wuxx/nanoDAP/README.md

## [nanoDAP 用户手册](https://github.com/wuxx/nanoDAP/blob/master/user_manual.md) / [nanoDAP User Manual](https://github.com/wuxx/nanoDAP/blob/master/user_manual_en.md)
## [nanoDAP DIY教程](https://github.com/wuxx/nanoDAP/blob/master/diy_tutorial.md) / [nanoDAP DIY Tutorials](https://github.com/wuxx/nanoDAP/blob/master/diy_tutorial.md)
