wuxx/nanoDAP/driver/windows7_serial_driver/README.md

CMSIS-DAP和DAPLink统一使用 mbedWinSerial_16466.exe 安装驱动，一般均可顺利安装。
