wuxx/nanoDAP/doc/a1.png

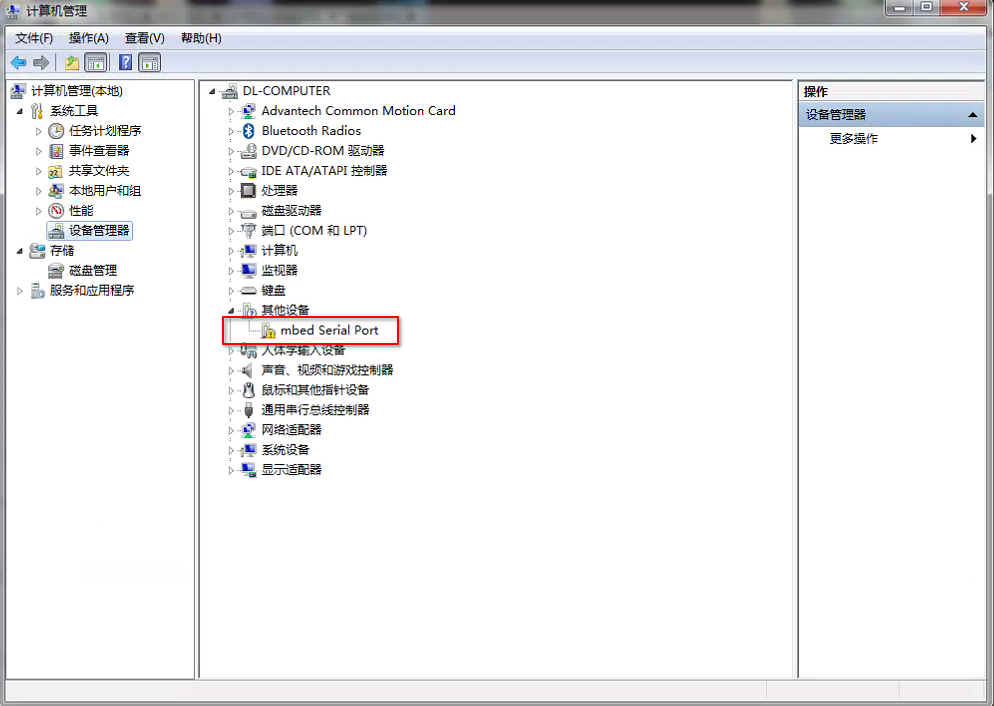
doc/a1.png
