wuxx/nanoDAP/doc/a2.png

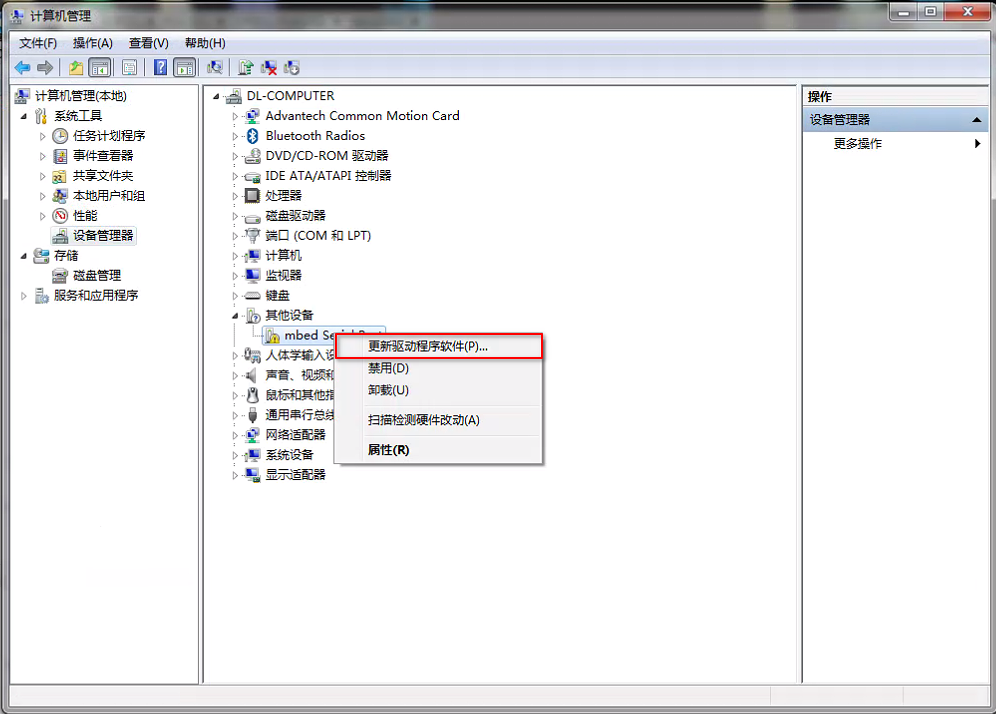
doc/a2.png
