wuxx/nanoDAP/doc/a3.png

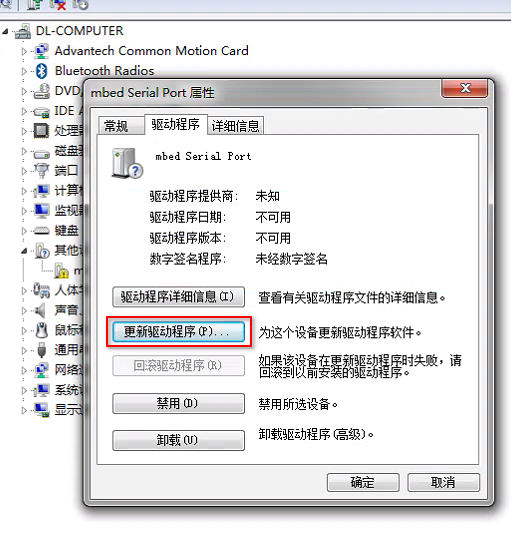
doc/a3.png
