wuxx/nanoDAP/doc/a4.png

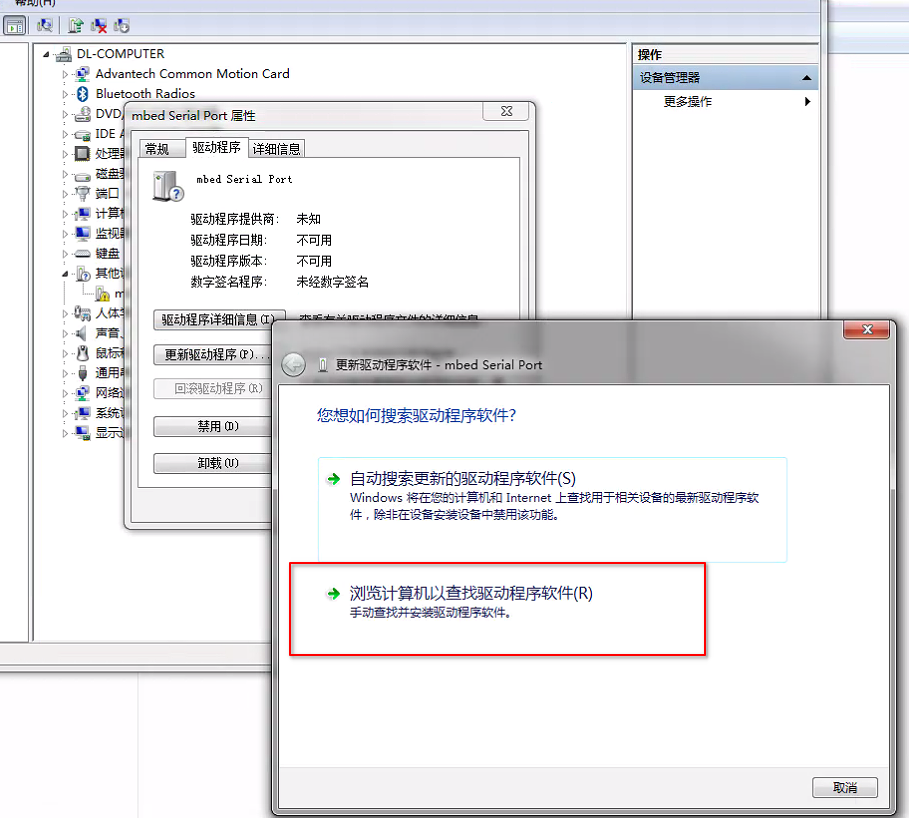
doc/a4.png
