wuxx/nanoDAP/doc/a5.png

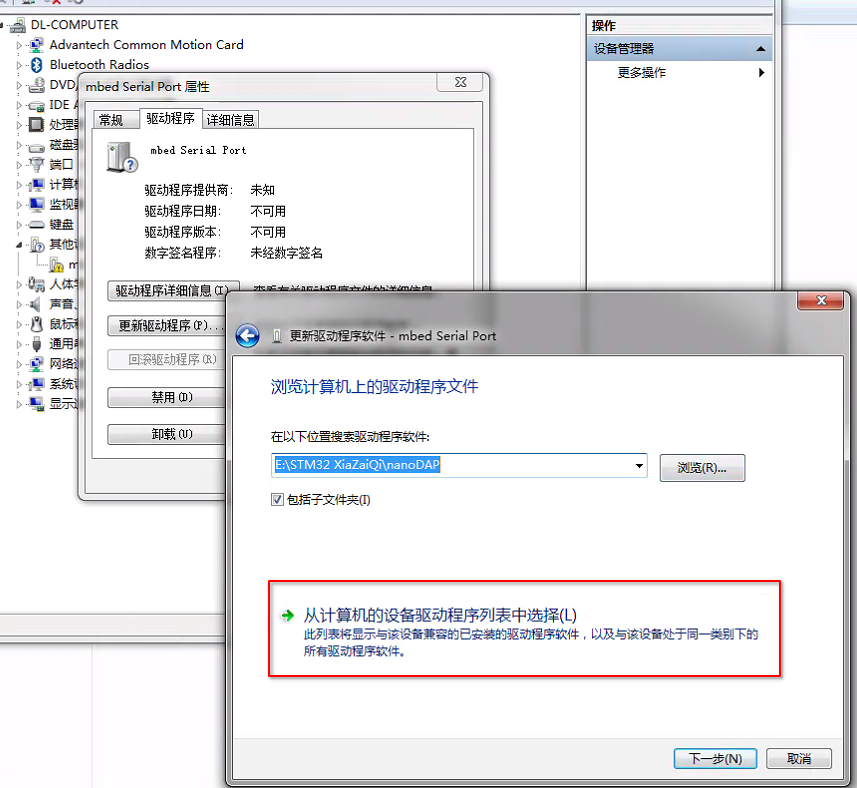
doc/a5.png
