wuxx/nanoDAP/doc/a6.png

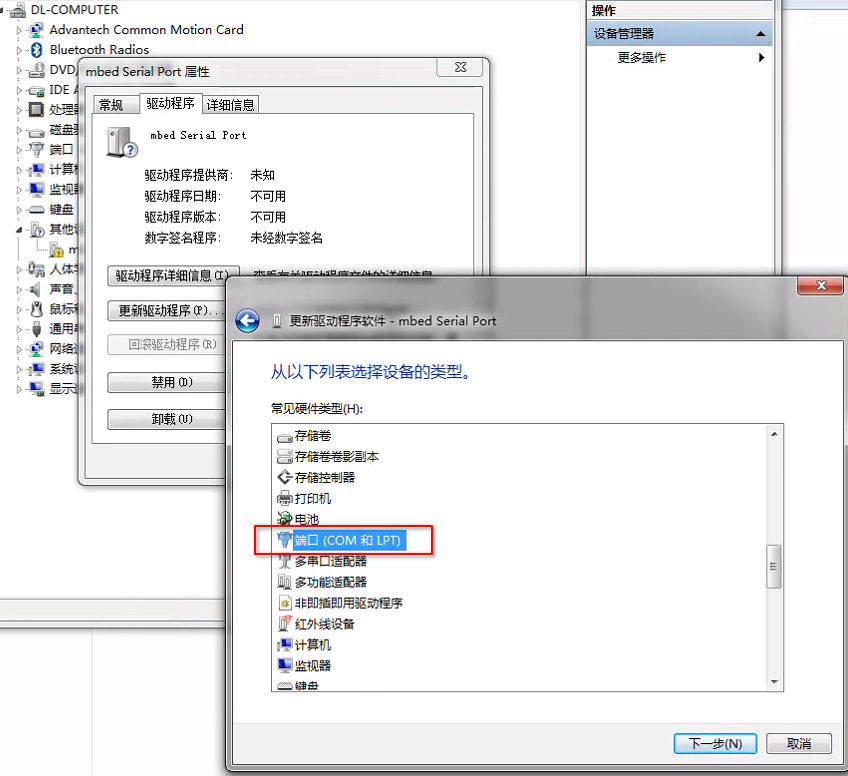
doc/a6.png
