wuxx/nanoDAP/doc/a7.png

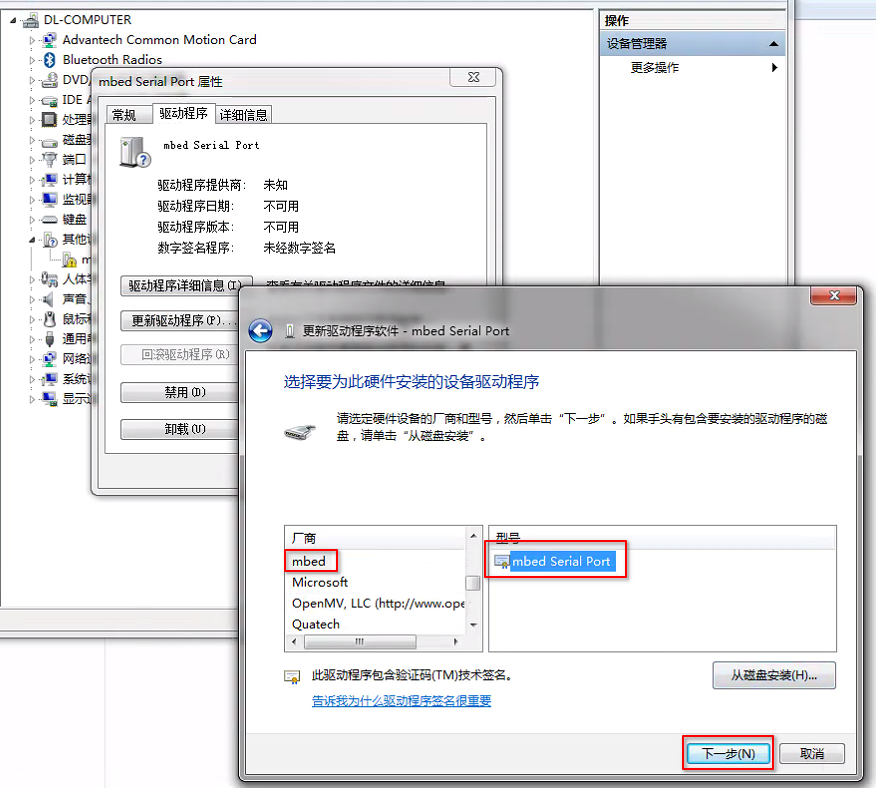
doc/a7.png
