wuxx/nanoDAP/doc/DAPLink_MSD1.png

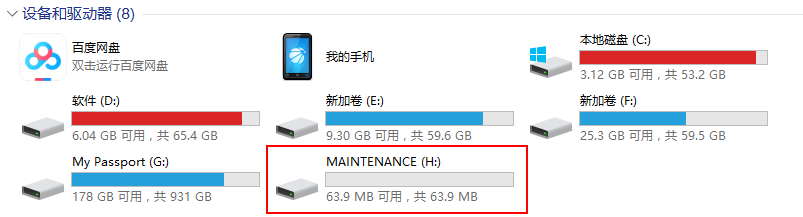
doc/DAPLink_MSD1.png
