wuxx/nanoDAP/doc/iar_config.png

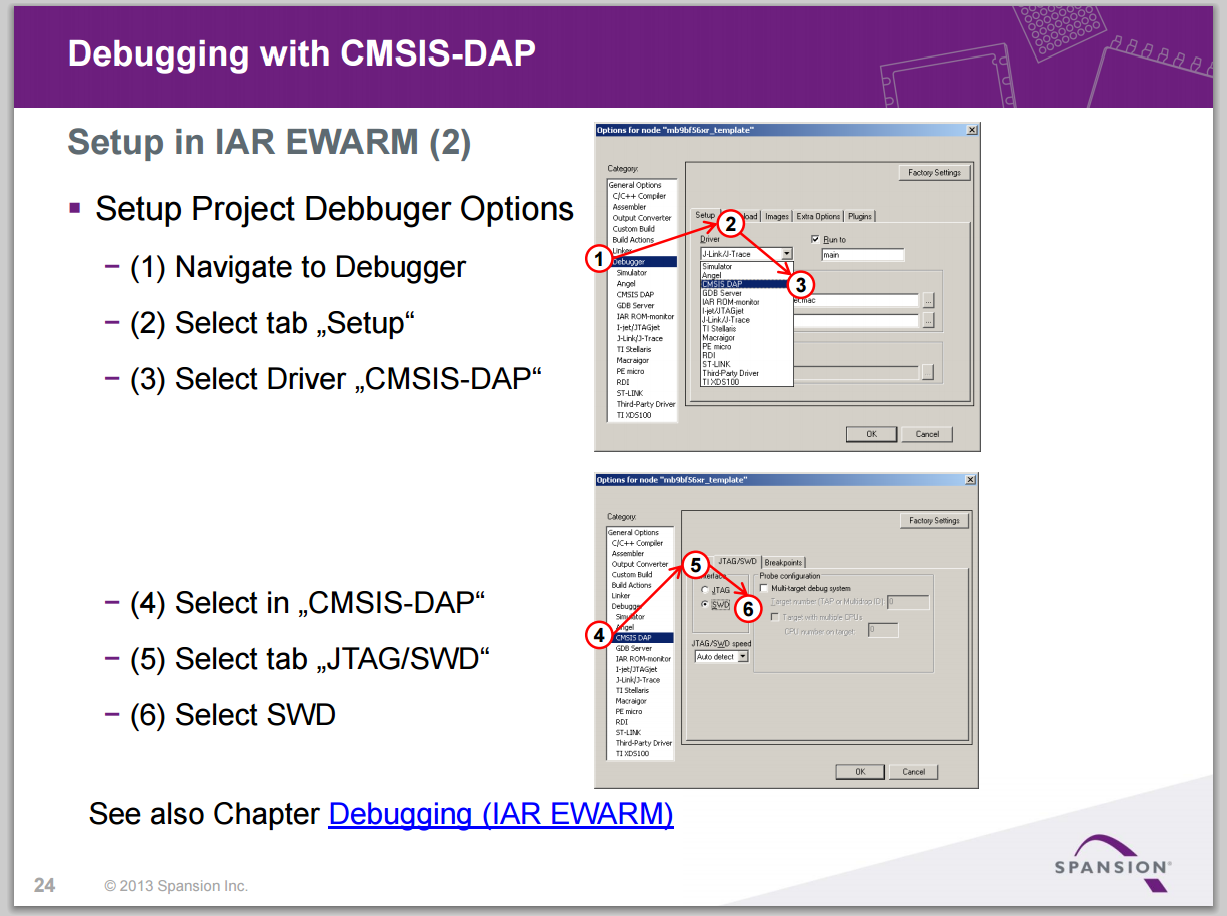
doc/iar_config.png
