wuxx/nanoDAP/doc/JTAG-SWD.png

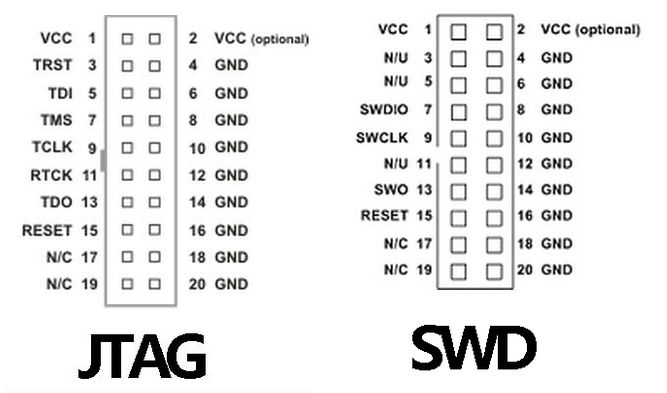
doc/JTAG-SWD.png
