wuxx/nanoDAP/doc/nanoDAP0.jpg

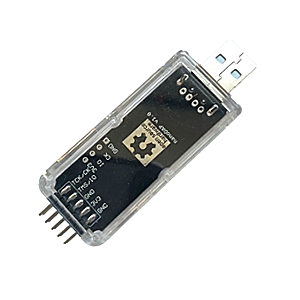
doc/nanoDAP0.jpg
