wuxx/nanoDAP/doc/nanoDAP3.jpg

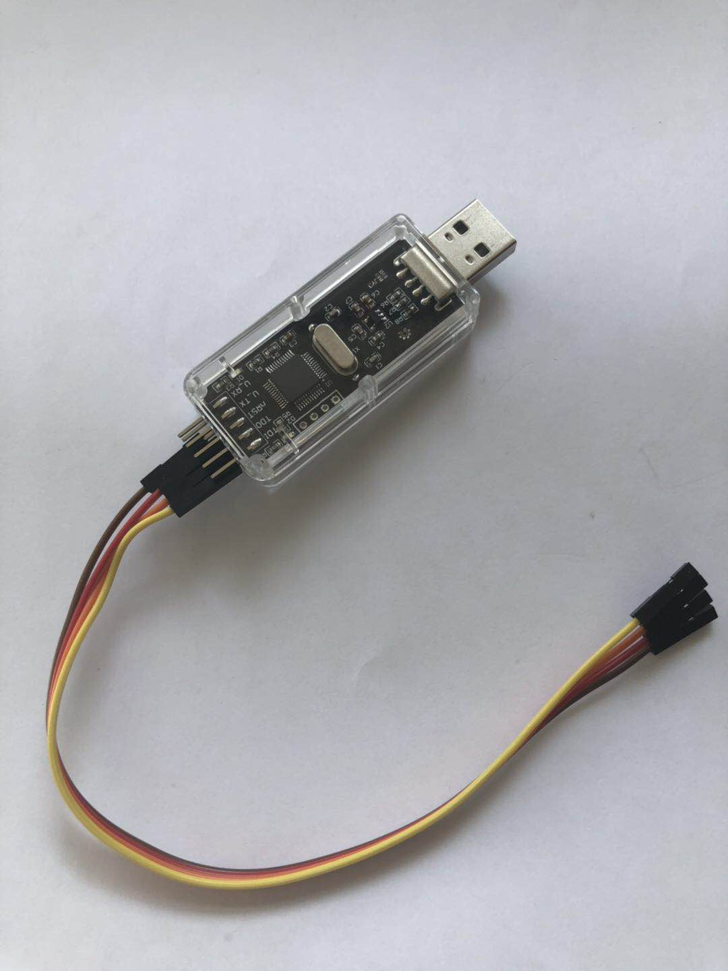
doc/nanoDAP3.jpg
