wuxx/nanoDAP/doc/nanoDAP4.jpg

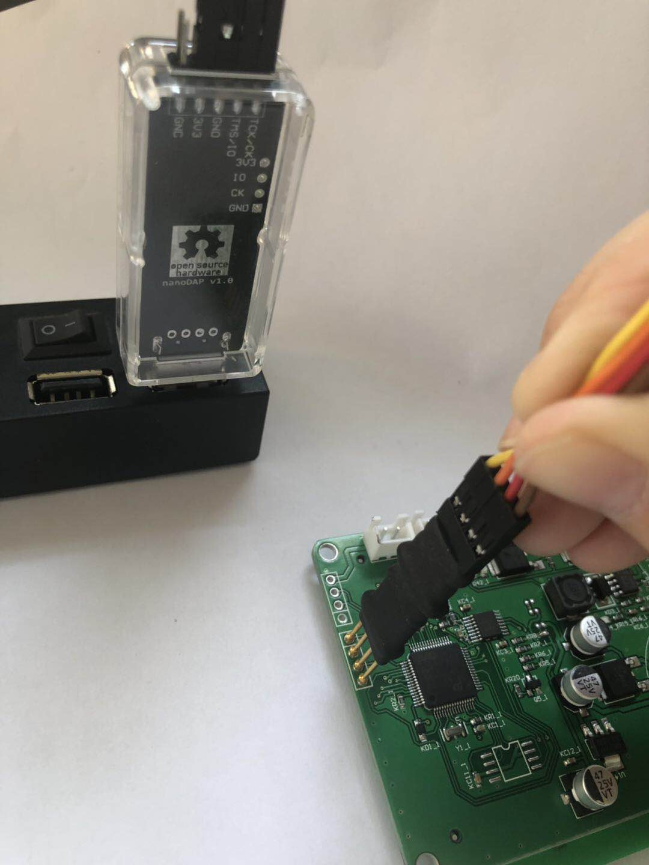
doc/nanoDAP4.jpg
