wuxx/nanoDAP/doc/nanoDAP5.jpg

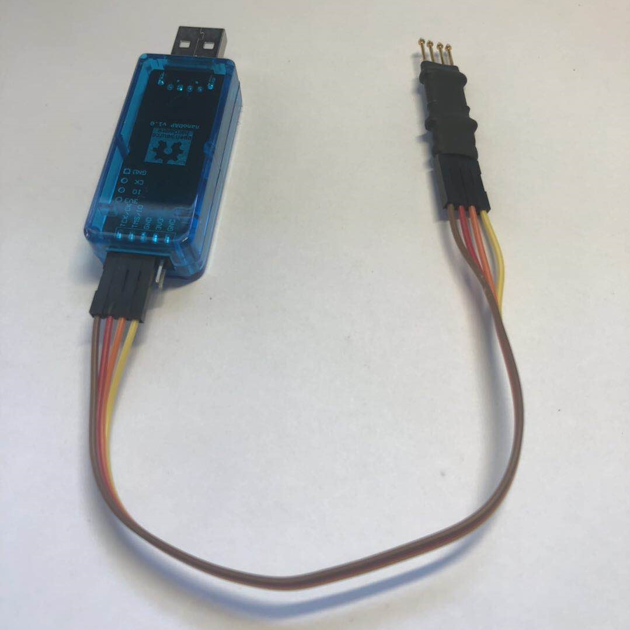
doc/nanoDAP5.jpg
