wuxx/nanoDAP/doc/nanoDAP6.JPG

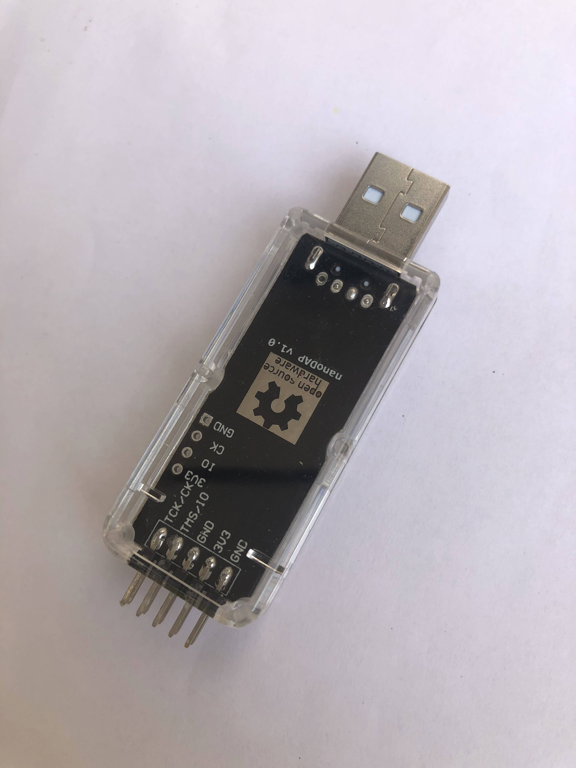
doc/nanoDAP6.JPG
