wuxx/nanoDAP/doc/nanoDAP7.jpg

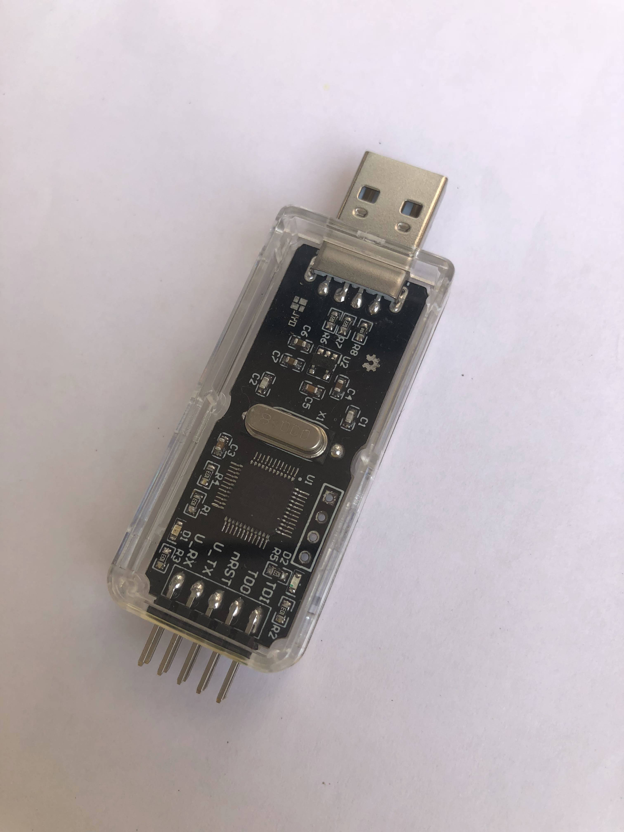
doc/nanoDAP7.jpg
