wuxx/nanoDAP/doc/nanoDAP22.jpg

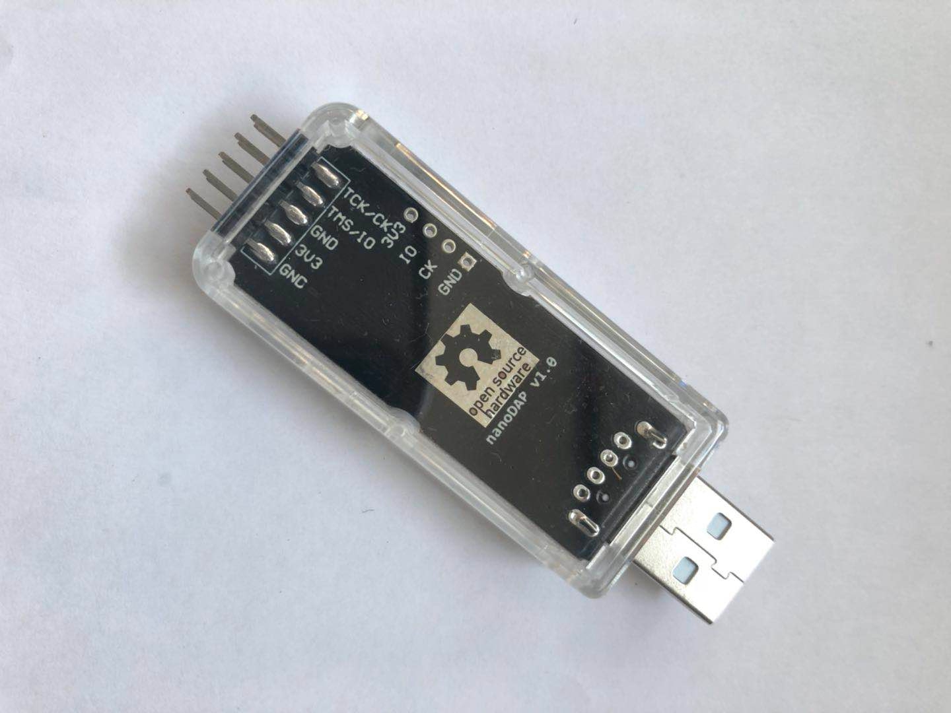
doc/nanoDAP22.jpg
