wuxx/nanoDAP/doc/PACK_CMSIS.png

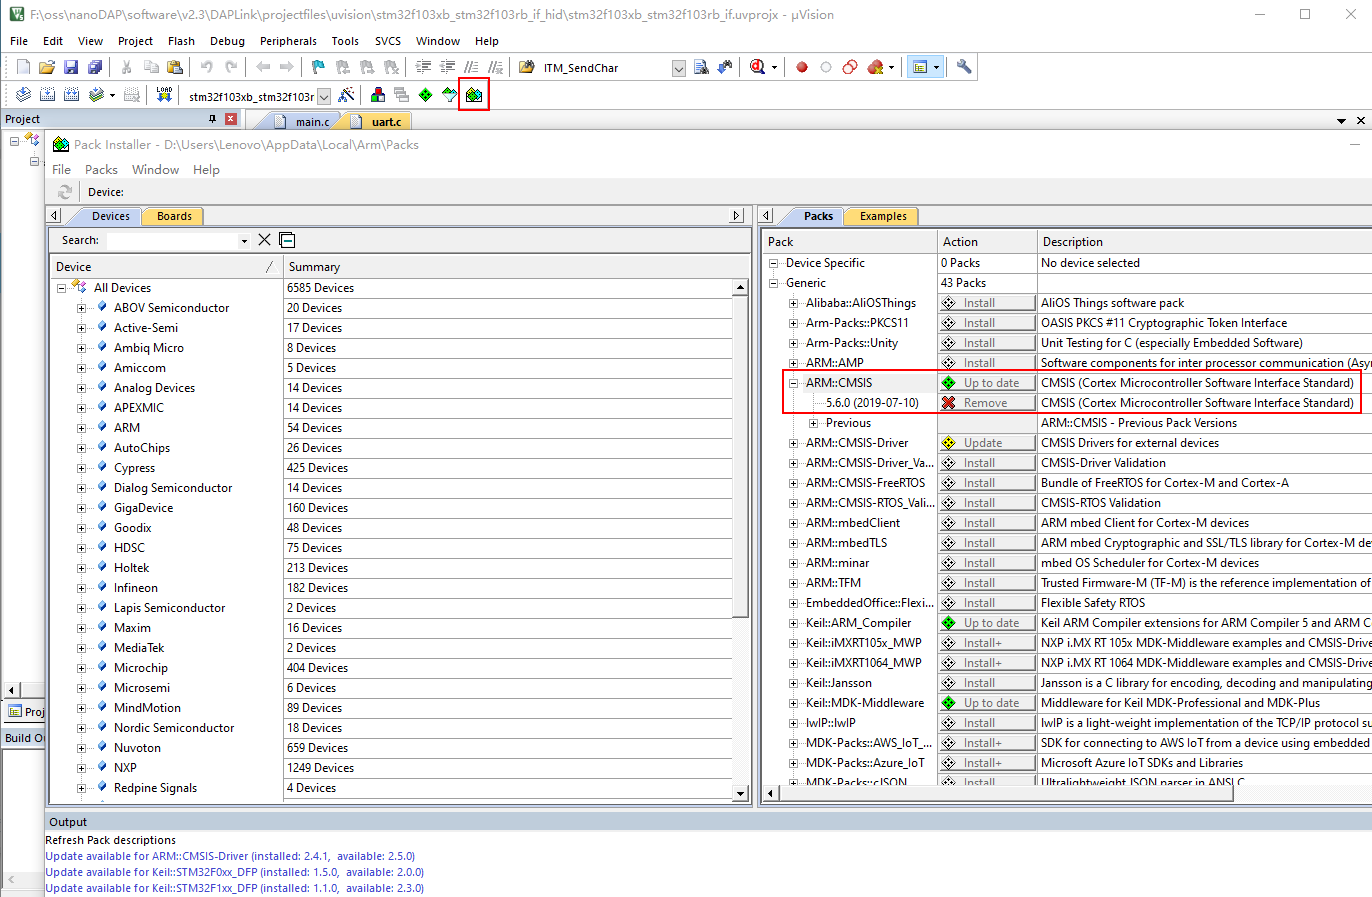
doc/PACK_CMSIS.png
