wuxx/nanoDAP/doc/rddi_dap_error.jpg

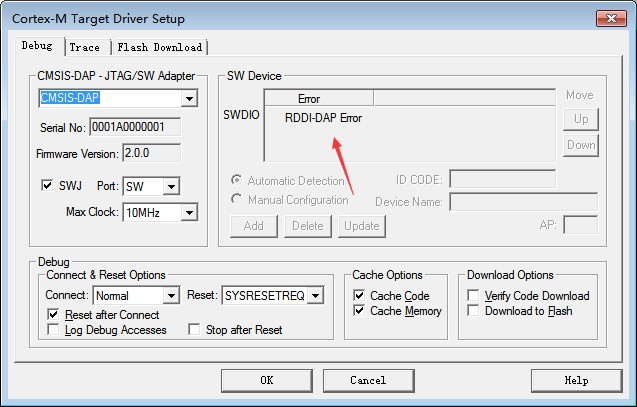
doc/rddi_dap_error.jpg
