wuxx/nanoDAP/doc/reset_and_run.png

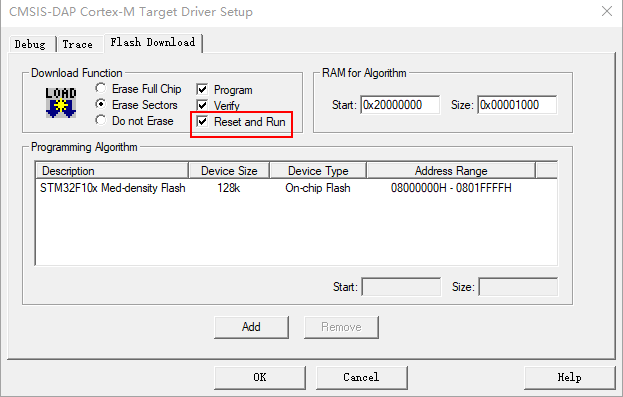
doc/reset_and_run.png
