wuxx/nanoDAP/doc/target_id.png

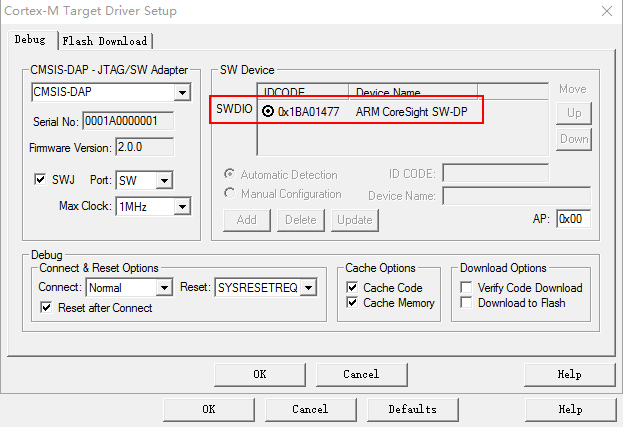
doc/target_id.png
