wuxx/nanoDAP/doc/pack_installer_cmsis.png

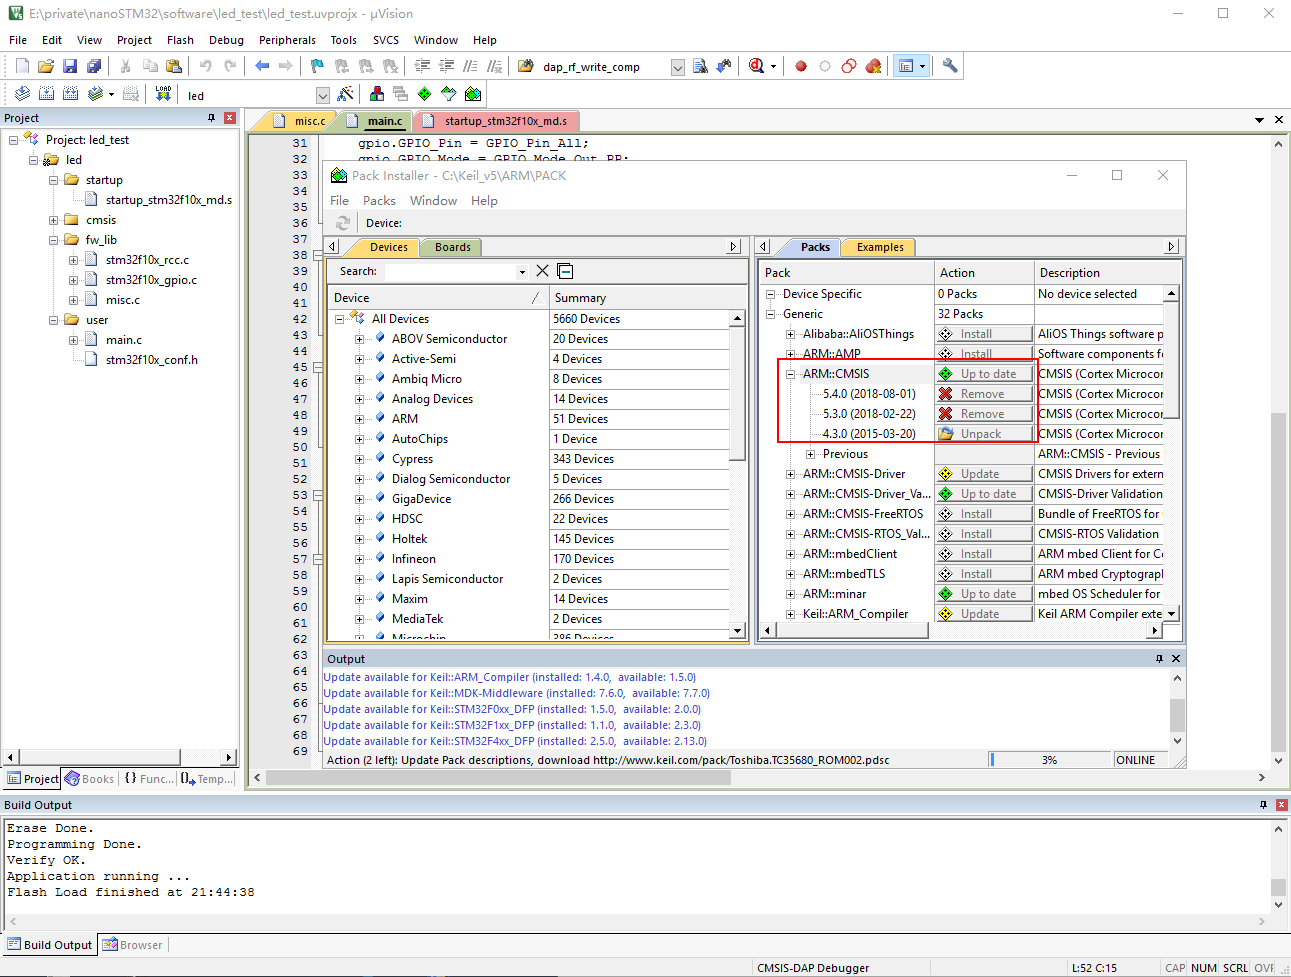
doc/pack_installer_cmsis.png
