wuxx/nanoDAP/(threads)

Thread 1 (2019-01-20):

无法安装应用firmware

xiayangchun, 2019-01-20:
你好，想请教一下，我使用STM32F103RBT6下载了boot loader文件后，重新给设备上电，并没有把RST与GND短接，然后识别出来一个U盘（MAINTENANCE），然后我把调试器的应用升级代码放在里面，是个bin文件，名字我随意取的，设备没有反应，我把调试器重新插拔，他还是跳出来U盘（MAINTENANCE），keil里也没有DAPLINK设备，想问下，如何把升级文件安装到下载调试器中，

wuxx, 2019-01-21:
你应该把固件拖动到里面，而不是bootloader文件，名字可以随意取

xiayangchun, 2019-01-21:
我拖得是固件，不是bootloader文件，我是使用stlink先把bootloader文件下载到DAPlink里面，这个时候daplink本身是没有应用固件，重新上电出来U盘。没有短接rst和gnd，我把daplink的应用文件拖进去，不是目标固件，重新上电，设备管理器也不出现hid设备，也没有虚拟串口，只有U盘设备，方便留个微信好或者QQ吗，我加你，我的微信和QQ都是308735647

wuxx, 2019-01-22:
已解决，需要把nRST拉高才能正常使用DAPLink，否则进入的是bootloader

Closed 2019-01-22.

Thread 3 (2019-07-06):

MDK编译后丢失很多文件

jiki-mo, 2019-07-06:
您好，MDK编译后丢失很多文件，按照您的提示安装了MDK5.15，CMSIS.5.4.0，造成这个原因主要是您建立这个文件的时候有太多文件的依赖关系在您的电脑其他文件里，导致您把这个项目打包上来时丢了依赖的文件，然后我很难找您的文件，您看下能否把依赖的文件也包含进来，这样移植性就很高了，谢谢。

wuxx, 2019-07-07:
应该是这位朋友安装MDK时候部分库没安装全，
C:\Keil_v5\ARM\RV31和C:\Keil_v5\ARM\RL 这两个目录是编译时候需要的访问的，重新从其他拷贝这两个目录加入编译就可以了

wuxx, 2020-03-22:
已经压缩放到doc目录下了，下载下来直接解压到keil_v5/ARM/目录下应该就可以了
https://github.com/wuxx/nanoDAP/tree/master/doc

Closed 2019-07-06.

Thread 4 (2019-08-06):

串口悬空的时候会不停的发二进制0

MomentDerek, 2019-08-06:
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

串口悬空就会这样，但是接上开发板后恢复正常

MomentDerek, 2019-08-06:
查找到了问题所在，就是串口的rx脚没有默认上拉，硬件上拉后恢复正常，但是代码我跑不通，firmware里面提供的固件可以使用，但是software里面的c8t6程序在修复完所有的文件关联后能够编译通过，但是下载后无法使用

wuxx, 2019-08-06:
参考的哪个硬件和软件版本？

MomentDerek, 2019-08-06:
> 参考的哪个硬件和软件版本？

哦哦哦，忘了，是c8t6版的

MomentDerek, 2019-08-06:
> 参考的哪个硬件和软件版本？

cbt6版本的cmsis-dap固件没有问题，但是要么只有拖拽，有么其他功能齐全没拖拽

wuxx, 2019-08-07:
有 v1.0 v2.0 v2.1几个版本，硬件和软件需要一一对应

wuxx, 2019-08-07:
串口的问题应该不影响正常使用

MomentDerek, 2019-08-07:
确实不影响使用……但是发现了bug不修一下吗23333

wuxx, 2019-08-07:
有的人认为是bug，有的人认为不是。就我所知，市面上所有其他串口工具都是没有上拉的

Closed 2019-08-07.

Thread 5 (2019-09-02):

STM32CubeIDE  调试配置

mengyyy, 2019-09-02:
参考了一下 [屋脊雀工作室](http://www.wujique.com/2019/05/25/stm32cubeidemsys2openocddaplink%e8%b0%83%e8%af%95stm32h750vb/) 写的教程或者[这里](http://www.stmcu.org.cn/module/forum/forum.php?mod=viewthread&tid=620709)
试了一下但是有问题不成功 关键在于openocd配置文件有问题
试着改了一下openocd的配置文件 确实是能和stm32CudeIDE 调试了
但是感觉反应特别慢 具体表现在单步调试点半天才到下一步
但是在keil4里使用CMSIS调试反应却很快
想知道是什么原因造成stm32CubeIDE里调试反应慢？

附配置文件 **daplink-stm32f4.cfg**
板子主频设成8000kHz也就是8MHz 按[官方说4MHz就够了](https://github.com/ARMmbed/DAPLink/issues/627)
```
# This is an genericBoard board with a single STM32F429BITx chip
#
# Generated by STM32CubeIDE
# Take care that such file, as generated, may be overridden without any early notice. Please have a look to debug launch configuration setup(s)

source [find interface/cmsis-dap.cfg]

# set WORKAREASIZE 0x8000

# transport select "swd"

# set CHIPNAME STM32F429BITx
# set BOARDNAME genericBoard

# Enable debug when in low power modes
# set ENABLE_LOW_POWER 1

# Stop Watchdog counters when halt
# set STOP_WATCHDOG 1

# STlink Debug clock frequency
set CLOCK_FREQ 8000

# use hardware reset, connect under reset
# connect_assert_srst needed if low power mode application running (WFI...)
# reset_config srst_only srst_nogate connect_assert_srst
# set CONNECT_UNDER_RESET 1

# BCTM CPU variables

source [find target/stm32f4x.cfg]
```
以及启动GDB调试服务器的脚本  **debug.bat**
先运行这个再在stm32CubeIDE里启动调试
```
@REM stm32CubeIDE openocd读取配置文件的路径
@SET CONF_PATH=C:\ST\STM32CubeIDE_1.0.2\STM32CubeIDE\plugins\com.st.stm32cube.ide.mcu.debug_1.0.2.201907120816\resources\openocd\st_scripts

@REM stm32CubeIDE openocd 执行文件路径
@SET OPENOCD_PATH=D:\ST\STM32CubeIDE_1.0.2\STM32CubeIDE\plugins\com.st.stm32cube.ide.mcu.externaltools.openocd.win32_1.0.0.201904181610\tools\bin

REM 脚本当前路径
@SET ORIGIN_PATH=%CD%

@REM openocd配置文件名
@SET CFG_NAME="daplink-stm32f4.cfg"

@REM openocd加载 cmsis-dap配置 和 stm32f4 配置
@rem "%OPENOCD_PATH%\openocd.exe" -f "%CONF_PATH%\interface\cmsis-dap.cfg"  -f "%CONF_PATH%\target\stm32f4x.cfg"

@REM 替换配置文件夹路径下配置文件
@xcopy /s/Y "%ORIGIN_PATH%\%CFG_NAME%" "%CONF_PATH%\%CFG_NAME%"

@REM 切换到stm32Cube IDE openocd读取配置文件的路径
@cd /d "%CONF_PATH%"

@REM 后台启动opnocd服务
START  "openocd" "%OPENOCD_PATH%\openocd.exe" -f "%CONF_PATH%\daplink-stm32f4.cfg"

@REM 切回原始路径
@cd /d "%ORIGIN_PATH%"
```

wuxx, 2019-09-07:
stm32CubeIDE里只能用openocd + cmsis-dap吗，推测可能是stm32CubeIDE本身的调度问题，你可以试试看脱离stm32CubeIDE，只用 openocd + cmsis-dap 进行调试，输入命令telnet localhost port（openocd监听的端口号），可以进行调试

Closed 2019-11-15.

Thread 6 (2019-09-04):

Windows7 下无法识别问题

mengyyy, 2019-09-04:
win7 上插入DAPLink 后 有时会出现安装驱动程序 但经常显示无法识别设备

驱动问题显示为  **该设备已被禁用,原因是,设备的固件没有提供必需的资源.(代码29)**

后面查了一下 有人也遇到这个[问题](https://discuss.redbear.cc/t/daplink-v1-0-cannot-be-recognized-by-win7/1112/16)

起始原因是要是一开始就让usb四根线同时和电脑相连 但是此时DAPLink还没启动完成 win7上电脑也就认为硬件没有准备好资源 造成无法识别

他的解决方法是先把DAPLink的一部分插入usb口  也就是让 usb的两个电源线先上电 等DAPLink启动完成后 再插入剩下的部分接触两根数据线让电脑和DAPLink交互数据识别硬件资源

实际上也能观察到 dapLink的usb接口处 边缘的两个触点是稍微长一点的 是可以做到让这两点先接触 再插入剩余部分让中间两点后接触的
+ 先一点点插入DAPLink 做到让DAPLink上灯亮 但是不能让电脑识别
+ 等几秒插入剩下部分
```
Hi, I encounter the same issue. It seems the DAPLink power up time is too long. so when win7 tries to comunicate with it, the DAPLink is still in initialization, and so will not response. Then when its actually ready, win7 already terminates the connection.

Currently the only workaround i use is to plug the DAP link partially (to make sure its properly powered first) then fully push it to USB port to start conection.

PS : I also Tried in Mac and this issue did not exist. Seems like the driver in windows need some modification or the hardware need to be fixed.

Hope it helps.
```

wuxx, 2019-09-07:
你用的是什么硬件版本？是V2.0还是V2.1，V2.1已经在USB D+加上GPIO控制上拉了，这个问题应该不会出现了。

mengyyy, 2019-09-09:
v2.0

wuxx, 2019-09-09:
v2.0 D+上是直接上拉的，所以在部分windows系统上是会出现枚举失败的问题，慢慢插入可以解决，刷成cmsis-dap 的固件也可以解决。也可以尝试一下修改DAPLink启动代码

Closed 2019-09-20.

Thread 7 (2019-11-02):

建议在readme 加上feature list

WuYingzheng, 2019-11-02:
建议在readme 加上feature list
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

phone13543016677, 2019-12-25:
老大, 我也借鉴你的方案了.
之前CMSIS-DAP做了三线自动复位的, DAPLink也打算改改, 但自行改了几次工作都不太稳定, 不知道哪里出问题了, 直至后来发现你的开源方案.
完善后, 打算也挂到淘宝上, 赚点烟钱, 弄个钱不容易吖~~~
硬件上,  参考了官方图,技小新,电子创客营的, 还有老大你的, 综合修改, USB上拉修改了一点, 删了4个作用不大的电阻,烧录口加退耦......
软件上,  以你的开源代码为主, 配合几个网上方案作修改的,
目前在自家win7上, 三线软复, 10M, 棒棒的.
老大, 有空多联系指导:  safang@139.com

wuxx, 2019-12-25:
可以的，没问题

Closed 2020-03-22.

Thread 8 (2020-04-03):

无法给探索者F4下载程序

luhua2018, 2020-04-03:
有一个问题，这个下载器无法给原子探索者F4的开发板下载程序，芯片倒是可以间歇性的识别出来一下，但是下载程序肯定出错。

我给同一个下载器烧了jlink-OB固件就可以正常用，但是用DAP就不行，不知道这个问题是什么原因。

wuxx, 2020-04-04:
你好，请问是你自己制作的dap，还是我们这里购买的？
如果jlink-ob可用，说明硬件应该是没问题的，可以检查以下几点
1.  杜邦线是否接触良好，尝试换一组杜邦线试试看
2. 尝试将速度调低
3. 确认目标板供电是否没问题

luhua2018, 2020-04-04:
常规办法都已经试过了，剩下的都是玄学问题：

1. 杜邦线缩到了 5cm ，速度降到了 50k ，供电也保证没问题。

2. 同样的条件下刷 JLink 固件就可以用 DAP 固件就不行。

3. 我查了探索者开发板的原理图发现它的 TCK 是 10k 下拉的，当我把它改成 10k 上拉后芯片可以被识别到了但是下载仍然出错。

所以我怀疑可能是 DAP 的驱动能力不足？毕竟探索者开发板的 jtag 接口离芯片有点远，可是同样的下载器刷 JLink 固件又能正常用。不知道这种情况有没有可能通过软件解决？

下载器是从淘宝店买的。我这里只有这一种 DAP ，好像正点原子官方也出了 DAP 下载器不知道他们有没有遇到这种情况。

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

wuxx, 2020-04-04:
1. 能否换另一块板子试试看？确定是dap的问题还是和板子有关系
2. 不知道你是怎么供电的，如果目标单板单独供电，建议dap只连接3根线 gnd clk io调试，不要接上3.3V
3. 调整杜邦线线序，让gnd夹在clk和io的中间，改善信号质量

luhua2018, 2020-04-04:
其他板子 F1 的、F0 的都没问题，只有特定的`正点原子的探索者F407开发板`不行。

算了，不纠结这个问题了，也许是他板子本身设计的 BUG 。

Closed 2020-04-04.

Thread 9 (2020-07-05):

cannot load flash programming algorithm

Dachtire, 2020-07-05:
1. 用SONiX_USB_MCU_ISP_Tool往键盘刷了一个烂固件，导致键盘不能识别。由于键盘没有留swd接口，所以就把芯片吹下来接到烧录座上。
2. 想通过keil重新烧录固件，芯片是EVISION VS11K15A，通过QFP48-0.5烧录座引出swd接到daplink，keil用的是SONiX SN32F268F的cmsis和pack (VS11K15A没有给出官方测试工具，所以用SN32F268F的测试工具，目前看来这两个芯片是一样的，测试过用SONiX_USB_MCU_ISP_Tool_V2.3.1.7里SN32F268F的usb isp给VS11K15A写固件没问题)，网上搜到的降速之类的也没用。
3. 有恢复用的.hex固件，是否可以通过coflash之类的软件烧录？但是coflash在Flash Driver一项里点击Add就闪退。目前没有搜到coflash的教程，不知如何使用。
4. 新接触单片机不知道哪里做错了，搜索引擎什么有用的都搜不到，请求帮助。
5. 有关资料
SONiX SN32F268F
http://www.sonix.cn/article-cn-558-24749
[SN32F268_V1.2_SC.pdf](https://github.com/wuxx/nanoDAP/files/4874400/SN32F268_V1.2_SC.pdf)
[SN32F268_V1.9_EN.pdf](https://github.com/wuxx/nanoDAP/files/4874401/SN32F268_V1.9_EN.pdf)
EVISION VS11K15A
http://evision.net.cn/download/icsc.html
[VS11K15A-20190413174718_2058.pdf](https://github.com/wuxx/nanoDAP/files/4874395/VS11K15A-20190413174718_2058.pdf)
6.相关截图
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

wuxx, 2020-07-05:
keil烧录一般需要源码，直接烧录hex可以试试
https://github.com/wuxx/openocd-toolbox
需要自己参考写个配置脚本

Dachtire, 2020-07-07:
> keil烧录一般需要源码，直接烧录hex可以试试
keil用的是源码，来自sonix官方给的SN32F260_CMSIS Firmware Library_V1.2里的一个demo，还是想问问这个报错有没有办法解决。
> 需要自己参考写个配置脚本
openocd写好了配置脚本，但是flash driver有问题。
[test.cfg.txt](https://github.com/wuxx/nanoDAP/files/4885740/test.cfg.txt)

1. 如果用cfi，会报Segmentation fault无法写入。
cfg里写的`flash bank $_FLASHNAME cfi 0x00000000 $_FLASH_SIZE 4 4 $_TARGETNAME`
chip_width是32bit=4Byte, 但是不知道bus_width在ic手册里哪里可以找到？目前填的就是4Byte。

执行终端输出
sudo openocd -f test.cfg -c "program SN32F260-usb-demo.hex"
Open On-Chip Debugger 0.10.0+dev-01293-g7c88e76a-dirty (2020-07-07-01:44)
Licensed under GNU GPL v2
For bug reports, read
	http://openocd.org/doc/doxygen/bugs.html
cortex_m reset_config sysresetreq

Info : CMSIS-DAP: SWD  Supported
Info : CMSIS-DAP: JTAG Supported
Info : CMSIS-DAP: FW Version = 0254
Info : CMSIS-DAP: Serial# = 07000001066fff373439575043063956a5a5a5a597969908
Info : CMSIS-DAP: Interface Initialised (SWD)
Info : SWCLK/TCK = 1 SWDIO/TMS = 1 TDI = 1 TDO = 1 nTRST = 0 nRESET = 1
Info : CMSIS-DAP: Interface ready
Info : clock speed 1000 kHz
Info : SWD DPIDR 0x0bb11477
Info : sn32f268f.cpu: hardware has 4 breakpoints, 2 watchpoints
Info : starting gdb server for sn32f268f.cpu on 3333
Info : Listening on port 3333 for gdb connections
target halted due to debug-request, current mode: Thread
xPSR: 0xc1000000 pc: 0x00000002 msp: 0x00905a4c
** Programming Started **
Segmentation fault

进telnet调试
> init
> halt
> reset init
target halted due to debug-request, current mode: Thread
xPSR: 0xc1000000 pc: 0x00000002 msp: 0x00905a4c
> flash write_image erase SN32F260-usb-demo.hex
Connection closed by foreign host.

2. 如果尝试用其他如stm32f1x，就是无法识别。参考自https://github.com/smp4488/dk63/blob/master/vs11k09a-1.cfg
sudo openocd -f test.cfg -c "program SN32F260-usb-demo.hex"
Open On-Chip Debugger 0.10.0+dev-01293-g7c88e76a-dirty (2020-07-07-01:44)
Licensed under GNU GPL v2
For bug reports, read
	http://openocd.org/doc/doxygen/bugs.html
cortex_m reset_config sysresetreq

Info : CMSIS-DAP: SWD  Supported
Info : CMSIS-DAP: JTAG Supported
Info : CMSIS-DAP: FW Version = 0254
Info : CMSIS-DAP: Serial# = 07000001066fff373439575043063956a5a5a5a597969908
Info : CMSIS-DAP: Interface Initialised (SWD)
Info : SWCLK/TCK = 1 SWDIO/TMS = 1 TDI = 1 TDO = 1 nTRST = 0 nRESET = 1
Info : CMSIS-DAP: Interface ready
Info : clock speed 1000 kHz
Info : SWD DPIDR 0x0bb11477
Info : sn32f268f.cpu: hardware has 4 breakpoints, 2 watchpoints
Info : starting gdb server for sn32f268f.cpu on 3333
Info : Listening on port 3333 for gdb connections
target halted due to debug-request, current mode: Thread
xPSR: 0xc1000000 pc: 0x00000002 msp: 0x00905a4c
** Programming Started **
Info : device id = 0x00000000
Warn : Cannot identify target as a STM32 family.
Error: auto_probe failed
embedded:startup.tcl:521: Error: ** Programming Failed **
in procedure 'program'
in procedure 'program_error' called at file "embedded:startup.tcl", line 586
at file "embedded:startup.tcl", line 521

3. 不知道和bootloader或者reset有没有关系，现在只在烧录座接了swd的四根线，其他针脚都是没接的。
ic说明书里描述的
BOOT — Internal pull-up in Boot loader, tie LOW to keep in Boot loader or left
HIGH to exit Boot loader and execute User program at boot time.
RESET — External Reset input. Schmitt trigger structure, active “Low”, normally
stay “High”.

wuxx, 2020-07-08:
先看keil中能否检测到芯片的idcode，这种错误有可能是芯片被保护了，导致无法烧录。

Closed 2020-07-10.

Thread 10 (2020-09-03):

编译的时候没有 RTL.h

xidianzhuxi, 2020-09-03:
编译的时候缺少rtl.h和usb_lib.c也没有core_cm3.h

xidianzhuxi, 2020-09-03:
上面问题解决了。现在是cmsis_compiler.h没有

wuxx, 2020-09-03:
参考
https://github.com/wuxx/nanoDAP/issues/3

xidianzhuxi, 2020-09-03:
这个问题我也解决了，现在的问题是这样的。我手上的这块是stm32F103RCT6.配置文件DAP_config.h需要如何修改呢？

wuxx, 2020-09-03:
应该不需要修改，直接编译出来就可以了

xidianzhuxi, 2020-09-03:
当然除了必要的GPIO口我更改了。有这么几个问题我没想明白：
1，firmware里面的hex文件是什么时候用
2，给MCU烧录的时候提示No Algorithm found for 08004000H-08008633H
然后虽然烧录成功了。但是检测不到,提示SWD/JTAG Communication Failure
另外关于LED灯的状态是什么意思呢，我有一个灯常亮，一个灯闪烁

xidianzhuxi, 2020-09-03:
ok，查看了DAP发现 PA0 是SWDIO，PA4是SWCLK。而不是电路图上的P12，P13.现在检测到了

xidianzhuxi, 2020-09-03:
烧录的时候一直是RDDI-DAP ERROR 速度我挨个都试了一遍都没有用。有没有可能是芯片不支持，或者是烧录算法的缺失？

wuxx, 2020-09-03:
这个是检测不到目标芯片，最常见的原因：
1. 线没有接好
2. 目标芯片没有上电

对于你从源码编译的固件，可能是IO没有配置对，参考一下提供的v2.3原理图

xidianzhuxi, 2020-09-04:
今天拿了宁一块ministm32 也就是stm32RCT6，发现烧录成功了。昨天那块stm32VB是检测不到目标芯片。根据文档说DAPLINK支持的芯片列表有限，所以我如果要自己针对其他芯片支持我需要怎么做？

**您可以自行编译固件，或者从本仓库的firmware目录下直接获取即可，假若您有自己的芯片平台需要支持拖拽烧录，可以参考目前的代码作修改。**

我比较困惑的是
1我似乎没有用到firmware目录下的文件.
2参考哪些代码做修改？
3修改后的代码该怎么用
感谢

wuxx, 2020-09-04:
1. 如果参考提供的原理图制作的DAP，可以直接烧录firmware下的固件
2. 如果用keil开发，基本上可以烧录所有cortex-m系列的单片机
3. 拖拽烧录每种固件一般只支持一种单片机烧录，支持其他单片机拖拽烧录需要更换固件，若DAPLink官方没有支持，则需要自己修改代码支持拖拽烧录其他目标芯片，具体参考flash_blob.c源文件，修改好重新编译就可以了

Closed 2020-09-05.

Thread 11 (2020-09-15):

关于SWD访问FLASH

xidianzhuxi, 2020-09-15:
我仔细阅读了ADI v5。想请教一下关于擦除和写入Flash这部分的内容，是如何通过SWD做到的呢？换言之，SWD通过操作哪些寄存器可以做到对FLASH的访问呢？

wuxx, 2020-09-15:
1. 通过SWD接口可以访问任意内存以及CPU寄存器
2. 配置NVIC寄存器，先暂停CPU，将烧录算法和flash数据先写入到SRAM中
3. 修改CPU PC寄存器指向烧录算法区域，再配置NVIC中相关寄存器令CPU恢复执行
4. CPU执行烧录算法，将SRAM中的flash数据写入到Flash中
5. 由于Flash空间一般来说远大于SRAM，所以以上步骤4是不断执行的
以上省略了一些细节操作，详细过程可以参考DAPLink中相关源码 swd_host.c flash_blob.c等
希望对你有所帮助

Closed 2020-09-16.

Thread 12 (2020-11-09):

我想新增一个flash算法该如何修改

xidianzhuxi, 2020-11-09:
请教一下，我已经有了一个新的芯片的flash下载算法。想知道本项目更改flash下载算法的代码在哪一块呢？

wuxx, 2020-11-09:
flash_blob.c

xidianzhuxi, 2020-11-09:
我搜索到了很多个flash_blob.c，当前生效的是哪一个？

wuxx, 2020-11-09:
stm32f103xb目录下的

xidianzhuxi, 2020-11-09:
应该有一处定义了选用那个目录下的吧，是哪一个文件定义了选用哪个目录下的

xidianzhuxi, 2020-11-09:
我把V1.0的目录单独拿出来，依然能够编译运行，说明该项目中没有包含到software/DAPLink/source里面的flash_blob.c呀。

wuxx, 2020-11-10:
只有DAPLink才支持拖拽烧录

Closed 2021-01-09.

Thread 15 (2021-07-19):

如何启用Trace功能

season-studio, 2021-07-19:
在MDK中的配置中，使能CMSIS DAP下的Trace功能，在基本的SWD连接之外，再将TDO口与目标板的SWO口连接，启动调试。IDE下方状态栏显示“Trace: No Synchronization”。目标板上用代码调用ITM_SendChar也没有任何输出。
用JLink则Trace和ITM输出都正常。

wuxx, 2021-07-24:
nanoDAP 不支持Trace，TDO只是一个普通的GPIO，没有SWO功能

Closed 2022-07-02.

Thread 16 (2021-07-27):

移植到其他mcu

ghost, 2021-07-27:
我能不能把你编译好的固件直接刷写进兼容stm32的mcu上？比如gd32 hk32 apm32等，同为f103cbt6
还是需要自行编译？
（最近stm32涨价太多了，实在买不起

thinhx2, 2022-02-03:
Yes

wuxx, 2022-02-03:
只测试过apm32可以，gd32不行

thinhx2, 2022-02-03:
> 只测试过apm32可以，gd32不行
I agree, for gd32 96mhz instead 72mhz, we must modify source. I know your product cant public firmware, then it just compatible with stm32 alternative 72mhz such as apm32,hk32,mm32

nulllaborg, 2022-03-05:
gd32 usb枚举时间很慢

Closed 2022-06-13.

Thread 17 (2021-09-04):

Why try to read an output pin?

llinjupt, 2021-09-04:
Hi wu,

I am not sure if it is an issue but it seems really strange.

JTAG TDI has been configured as an out put pin through pin_out_init().
At the same time there is another function PIN_TDI_IN() that tries to read this pin.

PIN_TDI_IN() is only called by DAP_SWJ_Pins() to check if the electrical level of TDI is changed.
So my question is that do you have any idea of this contradictory opeation -- try to read an output pin.

Thanks in adavnce!

wuxx, 2021-09-06:
Hello, I think it's just a convention,  the DAP_SWJ_Pins read all pin input value, include the TCK/SWCLK, nRESET, their are all config as output. the host application know it.

llinjupt, 2021-09-06:
>
>
> Hello, I think it's just a convention, the DAP_SWJ_Pins read all pin input value, include the TCK/SWCLK, nRESET, their are all config as output. the host application know it.

Thanks for your response and you are right that all these pins configured at output mode are read in DAP_SWJ_Pins(). I have checked NXP LPCxx MCU and STM32 specs which truly are able to support this freature. But I am pretty sure there are lots of MCUs that don't support such a feature to read an output pin. I am gonna check JTAG spec to see if it is a must be, maybe it is  a real issue. Thanks again.

Closed 2021-09-06.

Thread 19 (2022-04-01):

Linux中使用openocd/cmsis-dap返回错误

btvnlue, 2022-04-01:
你好，使用Linux的openocd 0.11.0-rc2链接cmsis-dap的interface，返回
Open On-Chip Debugger 0.11.0-rc2
Licensed under GNU GPL v2
For bug reports, read
        http://openocd.org/doc/doxygen/bugs.html
Info : Listening on port 6666 for tcl connections
Info : Listening on port 4444 for telnet connections
Warn : Using CMSIS-DAPv2 interface 1 with wrong class 10 subclass 0 or protocol 0
Info : Using CMSIS-DAPv2 interface with VID:PID=0xc251:0xf001, serial=0001A0000001
Warn : could not claim interface: Resource busy
Error: error writing data: Input/Output Error
Error: CMSIS-DAP command CMD_INFO failed.

试着刷了2.3最新的固件，结果还是一样，
有没有什么建议

btvnlue, 2022-04-01:
找到了，不好意思，要用v1协议，加入command
cmsis_dap_backend hid
就可以了

AIMERSAN, 2022-07-02:
你好 请问是如何在终端添加这条命令（cmsis_dap_backend hid）呢， 能否方便复制下

wuxx, 2022-07-02:
tcl/interface/cmsis-dap.cfg

AIMERSAN, 2022-07-02:
> tcl/interface/cmsis-dap.cfg
wuxx 谢谢你回复 不过我说的是openocd 的运行选项，你这个说的应该是openocd的启动配置文件吧。
另外这个问题我也解决了正如题主说的那样，只需要在启动命令添加cmsis_dap_backend hid即可，命令如下：openocd -f ~/自己的配置路径/openocd.cfg -c "cmsis_dap_backend hid"

LiHangBing, 2023-05-31:
不知道什么原因，换了个USB口（之前插在HUB上），居然能用了

wuxx, 2023-06-01:
好的

Closed 2023-06-01.

Thread 20 (2022-04-15):

程序烧录的时候提示：SWD/JTAG Communication Failure

1136132863, 2022-04-15:
程序烧录的时候提示：SWD/JTAG Communication Failure
且无法正常烧录，开发板供电正常

wuxx, 2022-04-15:
DAP提示SWD/JTAG Communication Failure或者 RDDI DAP Error 问题排查方法
此种现象是DAP没有检测到目标芯片，什么都不接，出来的就是这个问题现象，最大可能性是接线不对或者接触不良，可根据以下方法排查：
0. 打开Keil Debug -> Settings 标签页检查，注意SWJ勾选框必须勾选
1. 检查一下接线是否接错，或者接触不良，重新插拔，或者换组杜邦线试试看（注意：杜邦线长度最好不要超过30cm）
2. 排查目标板供电是否充足，若目标板功耗较高，尝试目标板单独供电，DAP不对其供电
3. 尝试换一块板子试试看，检查是否下载器问题
4. 尝试换一个下载器测试板子，检查是否是板子的问题
5. 按住目标板的复位按键，再打开这个页面，看其是否有反应，若按住复位按键可以检测到目标芯片，则可根据如下方法解决github.com/wuxx/nanoDAP/wiki/nanoDAP%E4%BD%BF%E7%94%A8%E7%96%91%E9%9A%BE%E6%9D%82%E7%97%87%E8%A7%A3%E6%9E%90

Closed 2022-04-22.

Thread 21 (2022-04-30):

Keil 无法识别 CMSIS-DAP

kendling, 2022-04-30:
你好，感谢你开源如此实用的项目。

我按照 V2.3 的原理图打样并焊接成功。

烧写 v2.3a 固件的 stm32f103xb_bl 和 stm32f103xb_stm32f103rb_if_bulk 之后。

已经成功识别到 COM 口和虚拟 U 盘了。

但是 Keil 无法识别到 CMSIS-DAP 。

请问这个问题要怎么解决？

kendling, 2022-04-30:
刷 stm32f103xb_stm32f103rb_if_hid 固件就可以识别到了，可能是 win7 环境下不支持 Bluk 模式的固件。

再次感谢！

Closed 2022-04-30.

Thread 23 (2022-07-02):

支不支持用nanoDAP JTAG调试VisionFive开发板？

worksage, 2022-07-02:
您好老师：@wuxx， 我从资料上理解到可以用nanoDAP JTAG调试RISC-V SOC，我的开发板是VisionFive开发板(https://github.com/starfive-tech/VisionFive)，但我之前没用过JTAG，所以需要弄明白搞确切！！！
https://forum.rvspace.org/t/connecting-to-visionfive-s-jtag-port-a-short-guide/514
上面是请教过的内容，还有这一篇关于VisionFive开发板的JTAG详情的文章(https://dram.page/p/visionfive-jtag-1/)！！！

想请老师给我些用nanoDAP JTAG调试RISC-V SOC的指导！！！如果适用VisionFive开发板购买哪款nanoDAP JTAG更合适？？？

wuxx, 2022-07-02:
你好，应该是用openocd调试对吗，可以的

wuxx, 2022-07-02:
一般情况推荐使用DAPLink，是最新的开源DAPLink代码，使用上可能更方便

worksage, 2022-07-02:
>

是的，ubuntu下openocd + gdb，还差仿真器没建起来

worksage, 2022-07-02:
我刚看老师的视频了，选那个高速的DAPLink更好是吧！如果用着合适，我会推荐到下面的论坛里：
https://forum.rvspace.org/t/connecting-to-visionfive-s-jtag-port-a-short-guide/514

wuxx, 2022-07-02:
好的，高速的速度更快一些，日常使用用普通速度的一般也够了

worksage, 2022-07-02:
还有请问老师，我不打算焊接JTAG插接头，怎么接线更好，下面是图片https://forum.rvspace.org/uploads/default/original/1X/db9e6878a00f6c3ca5b3cafbfd744d82c5070c1d.jpeg，

wuxx, 2022-07-02:
一般用杜邦线连接即可

worksage, 2022-07-02:
老师，若不焊接，那七个通孔怎么接杜邦线？

wuxx, 2022-07-02:
https://github.com/wuxx/nanoDAP/wiki/%E5%85%B3%E4%BA%8E%E6%8E%A5%E7%BA%BF%E8%AF%B4%E6%98%8E

worksage, 2022-07-02:
https://item.taobao.com/item.htm?spm=a1z10.5-c.w4002-21349689069.20.2b254af5TLGSqz&id=605653531236
老师，这款也可作为USB转TTL使用是吧

wuxx, 2022-07-02:
可以

worksage, 2022-07-02:
老师，我看上面的链接也没看明白https://github.com/wuxx/nanoDAP/wiki/%E5%85%B3%E4%BA%8E%E6%8E%A5%E7%BA%BF%E8%AF%B4%E6%98%8E，VisionFive开发板上那标着A的7个通孔必须焊接上插针吗？有没有免焊接的插针座？

wuxx, 2022-07-02:
需要焊插针

wuxx, 2022-07-02:
如果不焊插针，可以看看这种夹子行不行
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

worksage, 2022-07-02:
感谢老师解惑！！！

Closed 2022-07-09.

Thread 25 (2022-09-17):

烧录 STM32F401 失败

myst729, 2022-09-17:
不慎刷入一个带写保护的 tinyuf2 固件，按照对方建议要烧录其他固件只能用下载器。手头只有一个 CMSIS-DAP / nanoDap 2.2，烧录失败，看这条评论说是下载器的问题 https://github.com/adafruit/tinyuf2/pull/189#issuecomment-1163257209

请问是需要升级下载器固件吗？

wuxx, 2022-09-18:
下载器固件一般不需要再去升级

myst729, 2022-09-19:
那请问会是什么原因呢？业余选手有点找不到方向 😢 pyocd 的问题？

wuxx, 2022-09-19:
一般需要先用stlink去除写保护

myst729, 2022-10-01:
买了个十块钱的盗版stlink救回来了

Closed 2022-10-05.

Thread 27 (2023-04-27):

不识别芯片怎么回事啊

bihailantian655, 2023-04-27:
我用的103cb开发板，刷的固件，想测试一下能不能用。
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
这俩100r 的电阻没接   （swclk dio）直接接的目标板。

R9   R1 也没接。

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

keil中能识别 daplink ，刷的是2.3的这俩固件测试都不行。
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

under reset 和 norml 都不行
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

bihailantian655, 2023-04-27:
开发板原来的pb12 pb13引脚有外围电路，更改引脚为pb10 pb11以后。
出现了一个现象就是
keil 连接4个jtag 引脚 能用swd 模式识别芯片， jtag模式不能识别芯片
 只连接swdio swclk  gnd vcc    swd模式 不能识别被烧录的芯片。

LiHangBing, 2023-06-01:
[RadioOperator](https://github.com/RadioOperator)
/
[STM32F103C8T6_CMSIS-DAP_SWO](https://github.com/RadioOperator/STM32F103C8T6_CMSIS-DAP_SWO)
这个里面的蓝色药丸remap固件实测可以识别

Closed 2023-12-13.

Thread 28 (2023-05-25):

NXP MCUXpresso IDE 无法连接

MrAMS, 2023-05-25:
使用NXP MCUXpresso IDE 的 LinkServer连接RT1064板子时，IDE报错：

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

详细信息：

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

MrAMS, 2023-05-25:
已排查接线问题，
NXP LinkServer配置如下：
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

wuxx, 2023-05-26:
先试试看用有线的可以吗

MrAMS, 2023-05-26:
已经识别上了而且LinkServer连接上了
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
身边暂时没有其他的DAP

Closed 2024-07-01.

Thread 29 (2023-07-21):

Ubuntu烧写时 /stm32f4x.cfg:45: Error: target requires -dap parameter instead of -chain-position!

HowieHepburn, 2023-07-21:
终端：openocd -f /usr/share/openocd/scripts/interface/cmsis-dap.cfg -f /usr/share/openocd/scripts/target/stm32f4x.cfg -c init -c halt -c "flash write_image erase /home/howie/32_prj/p-centerborad/build/P-centerborad.bin 0x08000000" -c reset -c shutdown
Open On-Chip Debugger 0.12.0+dev-00271-g2c57d11c7-dirty (2023-07-19-20:04)
Licensed under GNU GPL v2
For bug reports, read
        http://openocd.org/doc/doxygen/bugs.html
DEPRECATED! use 'adapter driver' not 'interface'
Info : auto-selecting first available session transport "swd". To override use 'transport select <transport>'.
**_**/usr/share/openocd/scripts/target/stm32f4x.cfg:45: Error: target requires -dap parameter instead of -chain-position!
in procedure 'script'**_**
at file "embedded:startup.tcl", line 28
at file "/usr/share/openocd/scripts/target/stm32f4x.cfg", line 45
make: *** [Makefile:201：download] 错误 1

对应的
$_TARGETNAME configure -work-area-phys 0x20000000 -work-area-size $_WORKAREASIZE -work-area-backup 0

wuxx, 2024-07-01:
看上去是脚本的配置有问题

Closed 2024-07-01.

Thread 31 (2023-10-02):

SWD multidrop support?

arthurfprecht, 2023-10-02:
Hello!

I first would like to say that I appreciate this debugger very much. As far as my research goes, it is the only DAP debugger with JTAG and SWD support that runs on STM32F103 MCU, which is very handy (it is a very common MCU).
With the arrival of RP2040, the SWD support of the current nanoDAP is not up to date - RP2040 uses multidrop  SWD. I know that the DAPLink [mBed repo](https://github.com/ARMmbed/DAPLink) has an updated version of the firmware for STM32F103 - but then it does not support JTAG.

Would it be possible to add SWD multidrop support to the current nanoDAP? or, on the other hand, add JTAG to the newer DAP firmware, so we get the best of both worlds (JTAG support and multidrop SWD support, so ESP32, RP2040 and other targets can all be debugged by a single debugger, on STM32F103)?

Thank you for the attention!

wuxx, 2023-10-03:
[flash_image_for_pico.zip](https://github.com/wuxx/nanoDAP/files/12787622/flash_image_for_pico.zip)

wuxx, 2023-10-03:
hello，this 128KB firmware support multi-drop SWD（support RP2040）thanks~！
you can also check this repo  https://github.com/wuxx/pico-lab

arthurfprecht, 2023-10-03:
Woow, that's amazing! I will test it today! Thank you very much for the info and the image!

Closed 2023-10-06.

Thread 35 (2024-07-31):

Ubuntu匹配不到cmsis-dap

pwy583, 2024-07-31:
在ubunt22.04和20.04出现这样的错误（usb）已经连接，但是识别不到

我用的cfg文件的内容是：adapter driver cmsis-dap
错误：

Open On-Chip Debugger 0.12.0+dev-00659-g052a4a69b (2024-07-28-20:14)
Licensed under GNU GPL v2
For bug reports, read
	http://openocd.org/doc/doxygen/bugs.html
DEPRECATED! use 'adapter speed' not 'adapter_khz'
Warn : DEPRECATED! use '-baseaddr' not '-ctibase'
Warn : DEPRECATED! use '-baseaddr' not '-ctibase'
Warn : DEPRECATED! use '-baseaddr' not '-ctibase'
Warn : DEPRECATED! use '-baseaddr' not '-ctibase'
Info : Listening on port 6666 for tcl connections
Info : Listening on port 4444 for telnet connections
Error: unable to find a matching CMSIS-DAP device

wuxx, 2024-11-29:
你好，加sudo看看

Closed 2025-04-16.

Thread 36 (2025-01-19):

SWD communication failure

AshPugczup, 2025-01-19:
My Daplink dont see MCU which is NXP MKE18F512VLH16 and mcuexpresso ide shows

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

in other programs like keil uvision5 there is same swd communication failure error

but when i tried with stm32f103c8 it saw it normally in keil

does daplink support this mcu at all?

wuxx, 2025-01-24:
Hello, first check the wiring and power supply

Closed 2025-04-16.

Thread 37 (2025-02-08):

用 nano-DAP 來刷新 PICO、PICOW、PICO2 和 PICO2W (SWDIO)

symdeb, 2025-02-08:
我想使用 nano-DAP 來刷新 PICO、PICOW、PICO2 和 PICO2W (SWDIO)

將 GND、RESET、TCL、TCK 線連接至 PICO

Bus 002 Device 028: ID 0d28:0204 NXP ARM mbed

我可以看到 nanoDAP 的用途STM32F103CBT6. 所以看起来这是一个 DAP-LINK

openocd -f interface/cmsis-dap.cfg -f target/rp2350-dbgkey-nonsecure.cfg -c "adapter speed 5000" -c "main.elf verify reset exit"

sudo openocd -f interface/cmsis-dap.cfg -f target/rp2350-dbgkey-nonsecure.cfg -c "adapter speed 5000" -c "main.elf verify reset exit"

[1] ]在哪裡可以找到 nano-DAP 的 cmis-dap.cfg？
[2] 使用來自 https://github.com/raspberrypi/openocd/tree/sdk-2.0.0/tcl/target 的 cfg 檔案（請參閱附件）

[cfg.zip](https://github.com/user-attachments/files/18636216/cfg.zip)

Open On-Chip Debugger 0.12.0+dev-gebec950 (2025-01-20-23:51)
Licensed under GNU GPL v2
For bug reports, read
http://openocd.org/doc/doxygen/bugs.html
Warn : An adapter speed is not selected in the init scripts. OpenOCD will try to run the adapter at very low speed (100 kHz).
Warn : To remove this warnings and achieve reasonable communication speed with the target, set "adapter speed" or "jtag_rclk" in the init scripts.
Error: unable to find a matching CMSIS-DAP device

Nano-DAP 可以與 PICO 一起使用嗎？ 如果是，那麼可能是什麼問題？

wuxx, 2025-02-13:
https://github.com/wuxx/pico-lab

symdeb, 2025-02-15:
TMS_IO
 GND
 TCK

1. Bus 001 Device 004: ID 0d28:0204 NXP ARM mbed

2. sudo dmesg
[5192.482050] cdc_acm 2-1.2.1:1.0: ttyACM0: USB ACM device
[ 5210.173463] usb 1-2.2: new full-speed USB device number 4 using xhci_hcd
[ 5210.269168] usb 1-2.2: New USB device found, idVendor=0d28, idProduct=0204, bcdDevice= 1.00
[ 5210.269176] usb 1-2.2: New USB device strings: Mfr=1, Product=2, SerialNumber=3
[ 5210.269179] usb 1-2.2: Product: DAPLink CMSIS-DAP
[ 5210.269181] usb 1-2.2: Manufacturer: ARM
[ 5210.269183] usb 1-2.2: SerialNumber: 070000010668ff303430484257205021a5a5a5a597969908
[ 5210.280576] cdc_acm 1-2.2:1.1: ttyACM1: USB ACM device
[ 5210.285113] hid-generic 0003:0D28:0204.0003: hiddev1,hidraw2: USB HID v1.00 Device [ARM DAPLink CMSIS-DAP] on usb-0000:04:00.0-2.2/input3
[ 5210.336976] usb-storage 1-2.2:1.0: USB Mass Storage device detected
[ 5210.340175] scsi host8: usb-storage 1-2.2:1.0
[ 5210.340336] usbcore: registered new interface driver usb-storage
[ 5210.345511] usbcore: registered new interface driver uas
[ 5211.380033] scsi 8:0:0:0: Direct-Access     MBED     VFS              0.1  PQ: 0 ANSI: 2
[ 5211.380423] sd 8:0:0:0: Attached scsi generic sg5 type 0
[ 5211.382243] sd 8:0:0:0: [sde] 131200 512-byte logical blocks: (67.2 MB/64.1 MiB)
[ 5211.382601] sd 8:0:0:0: [sde] Write Protect is off
[ 5211.382604] sd 8:0:0:0: [sde] Mode Sense: 03 00 00 00
[ 5211.382827] sd 8:0:0:0: [sde] No Caching mode page found
[ 5211.382829] sd 8:0:0:0: [sde] Assuming drive cache: write through
[ 5211.397451]  sde:
[ 5211.397507] sd 8:0:0:0: [sde] Attached SCSI removable disk

3.  pull openocd
     $./configure --enable-cmsis-dap
    make

4. Add 2 lines to cmsis-dap.cfg
    cmsis_dap_backend hid
     transport select swd

5, sudo openocd -f interface/cmsis-dap.cfg -f target/rp2350.cfg

Open On-Chip Debugger 0.12.0+dev-gebec950 (2025-01-20-23:51)
Licensed under GNU GPL v2
For bug reports, read
	http://openocd.org/doc/doxygen/bugs.html
Info : Hardware thread awareness created
Info : Hardware thread awareness created
Info : Hardware thread awareness created
Info : Hardware thread awareness created
cortex_m reset_config sysresetreq
Info : Listening on port 6666 for tcl connections
Info : Listening on port 4444 for telnet connections
Warn : An adapter speed is not selected in the init scripts. OpenOCD will try to run the adapter at very low speed (100 kHz).
Warn : To remove this warnings and achieve reasonable communication speed with the target, set "adapter speed" or "jtag_rclk" in the init scripts.
Error: unable to find a matching CMSIS-DAP device

6, $openocd -f interface/cmsis-dap.cfg -f target/rp2350-dbgkey-nonsecure.cfg -c "adapter speed 5000" -c "main.elf verify reset exit"

 7.  DEPRECATED! use 'cmsis-dap backend', not 'cmsis_dap_backend'

8. sudo openocd -f interface/cmsis-dap.cfg -f target/rp2350.cfg

Open On-Chip Debugger 0.12.0+dev-gcf9c0b41c (2025-02-15-08:19)
Licensed under GNU GPL v2
For bug reports, read
	http://openocd.org/doc/doxygen/bugs.html
invalid backend argument to cmsis-dap backend <backend>

cat ./tcl/interface/cmsis-dap.cfg
# SPDX-License-Identifier: GPL-2.0-or-later

#
# ARM CMSIS-DAP compliant adapter
#
# http://www.keil.com/support/man/docs/dapdebug/
#

adapter driver cmsis-dap

# Optionally specify the serial number of CMSIS-DAP usb device.
# adapter serial 02200201E6661E601B98E3B9
cmsis-dap backend hid

symdeb, 2025-02-15:
PICO using CMSIS DAP interface
---------------------------------
```
git clone --recurse-submodules --remote-submodules https://github.com/openocd-org/openocd.git
cd jimtcl
./configure
make
sudo make install
cd ..

git clone https://github.com/libusb/hidapi.git
git clone hidapi
cd hidapi
./bootstrap
.configure
make
sudo make install

./bootstrap
./configure --enable-cmsis-dap
make
sudo make install
sudo openocd -f interface/cmsis-dap.cfg -f target/rp2350.cfg -c "program <project>.elf verify reset exit"

sudo openocd -f interface/cmsis-dap.cfg -f target/rp2350.cfg -c "program test_project.elf verify reset exit"
Open On-Chip Debugger 0.12.0+dev-01855-g73e9b7898-dirty (2025-02-15-22:47)
Licensed under GNU GPL v2
For bug reports, read
	http://openocd.org/doc/doxygen/bugs.html
Info : [(null)] Hardware thread awareness created
Info : [(null)] Hardware thread awareness created
Info : [rp2350.dap.core0] Hardware thread awareness created
Info : [rp2350.dap.core1] Hardware thread awareness created
cortex_m reset_config sysresetreq
Warn : An adapter speed is not selected in the init scripts. OpenOCD will try to run the adapter at very low speed (100 kHz).
Warn : To remove this warnings and achieve reasonable communication speed with the target, set "adapter speed" or "jtag_rclk" in the init scripts.
Info : CMSIS-DAP: SWD supported
Info : CMSIS-DAP: JTAG supported
Info : CMSIS-DAP: Atomic commands supported
Info : CMSIS-DAP: FW Version = 0254
Info : CMSIS-DAP: Serial# = 070000010668ff303430484257205021a5a5a5a597969908
Info : CMSIS-DAP: Interface Initialised (SWD)
Info : SWCLK/TCK = 1 SWDIO/TMS = 1 TDI = 0 TDO = 1 nTRST = 0 nRESET = 1
Info : CMSIS-DAP: Interface ready
Info : clock speed 100 kHz
Info : SWD DPIDR 0x4c013477
Info : [rp2350.dap.core0] Cortex-M33 r1p0 processor detected
Info : [rp2350.dap.core0] target has 8 breakpoints, 4 watchpoints
Info : [rp2350.dap.core0] Examination succeed
Info : [rp2350.dap.core1] Cortex-M33 r1p0 processor detected
Info : [rp2350.dap.core1] target has 8 breakpoints, 4 watchpoints
Info : [rp2350.dap.core1] Examination succeed
Info : [rp2350.dap.core0] starting gdb server on 3333
Info : Listening on port 3333 for gdb connections
Warn : [rp2350.dap.core1] VECTRESET is not supported on this Cortex-M core, using SYSRESETREQ instead.
Warn : [rp2350.dap.core1] Set 'cortex_m reset_config sysresetreq'.
[rp2350.dap.core0] halted due to breakpoint, current mode: Thread
xPSR: 0xf9000000 pc: 0x00000088 msp: 0xf0000000
[rp2350.dap.core1] halted due to breakpoint, current mode: Thread
xPSR: 0xf9000000 pc: 0x00000088 msp: 0xf0000000
** Programming Started **
Error: couldn't open test_project.elf
** Programming Failed **
shutdown command invoked

```

symdeb, 2025-02-15:
PICO using CMSIS DAP interface (SOLVED)
=========================================================================================
```
git clone --recurse-submodules --remote-submodules **https://github.com/raspberrypi/openocd.git**

# when using raspberry git repo instead of openOCD git
# to skip calloc error
**export CFLAGS="-Wno-error=calloc-transposed-args"**

./bootstrap
./configure --enable-cmsis-dap
make
sudo make install

sudo openocd -f interface/cmsis-dap.cfg -f target/rp2350.cfg -c "program pico-ssd1306.elf verify reset exit"

```

Closed 2025-04-16.

Thread 39 (2025-07-27):

使用pyocd时无法reset目标; 无法刷新最新固件

StreakingJerry, 2025-07-27:
我尝试用pyocd reset -t stm32f429xi -m (default, hw, sw, sysresetreq, vectreset, emulated)几种方法都尝试过，均无法成功reset开发板。我怀疑是固件版本问题，于是尝试更新固件，但仅可以更新[interface_20240412.bin](https://github.com/wuxx/nanoDAP/blob/master/firmware/v2.3/DAPLink/interface_20240412.bin)，如果更新[flash_image_20240412.bin](https://github.com/wuxx/nanoDAP/blob/master/firmware/v2.3/DAPLink/flash_image_20240412.bin)则会显示```error: The application file format is unknown and cannot be parsed and/or processed.
type: user```. 更新完成后依旧无法成功重置开发板
