wuxx/nanoDAP/hardware/V2.3/dap2jtag.pdf

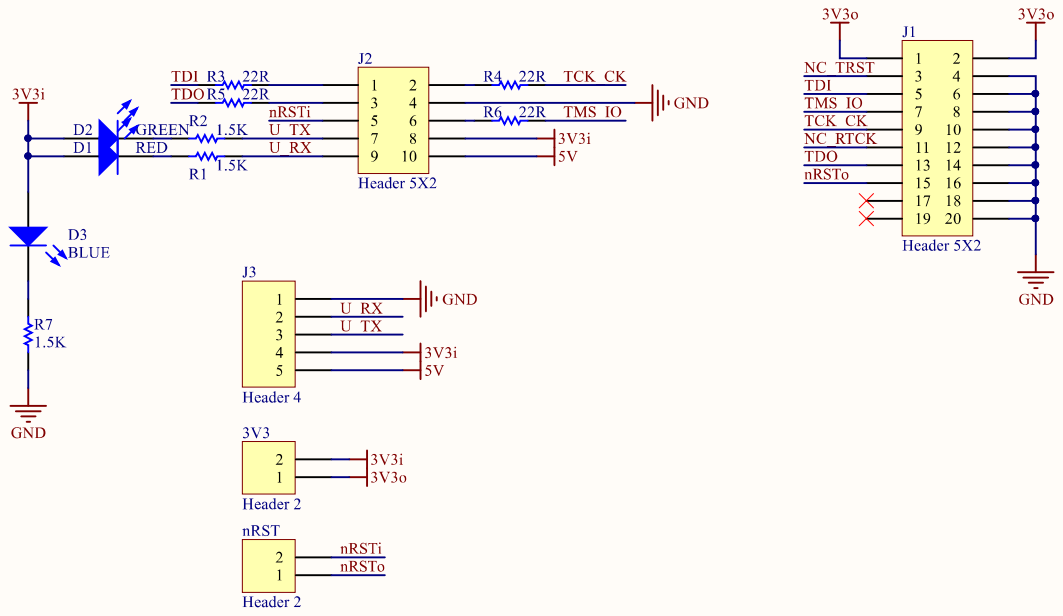
[picture p35: page 1]
