wuxx/nanoDAP/doc/STM32-DIPDAP-v1.0.0-SCH.pdf

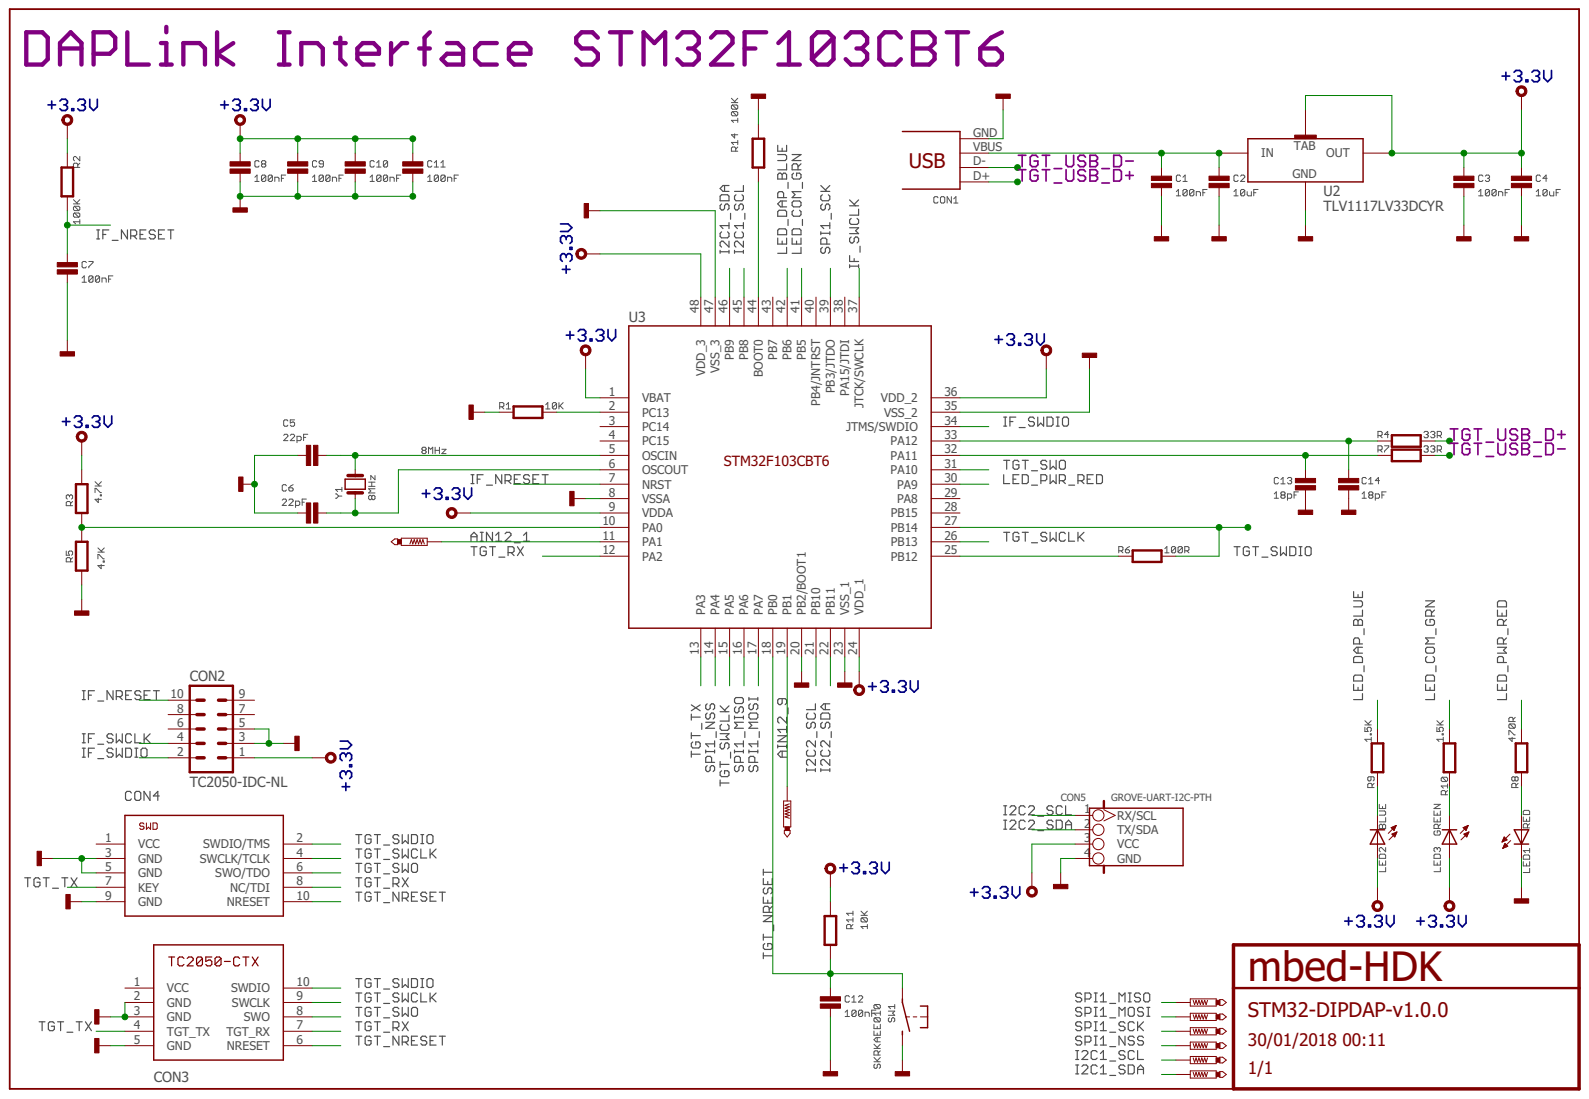
[picture p36: page 1]
