wuxx/nanoDAP/hardware/V2.1/nanoDAP.pdf

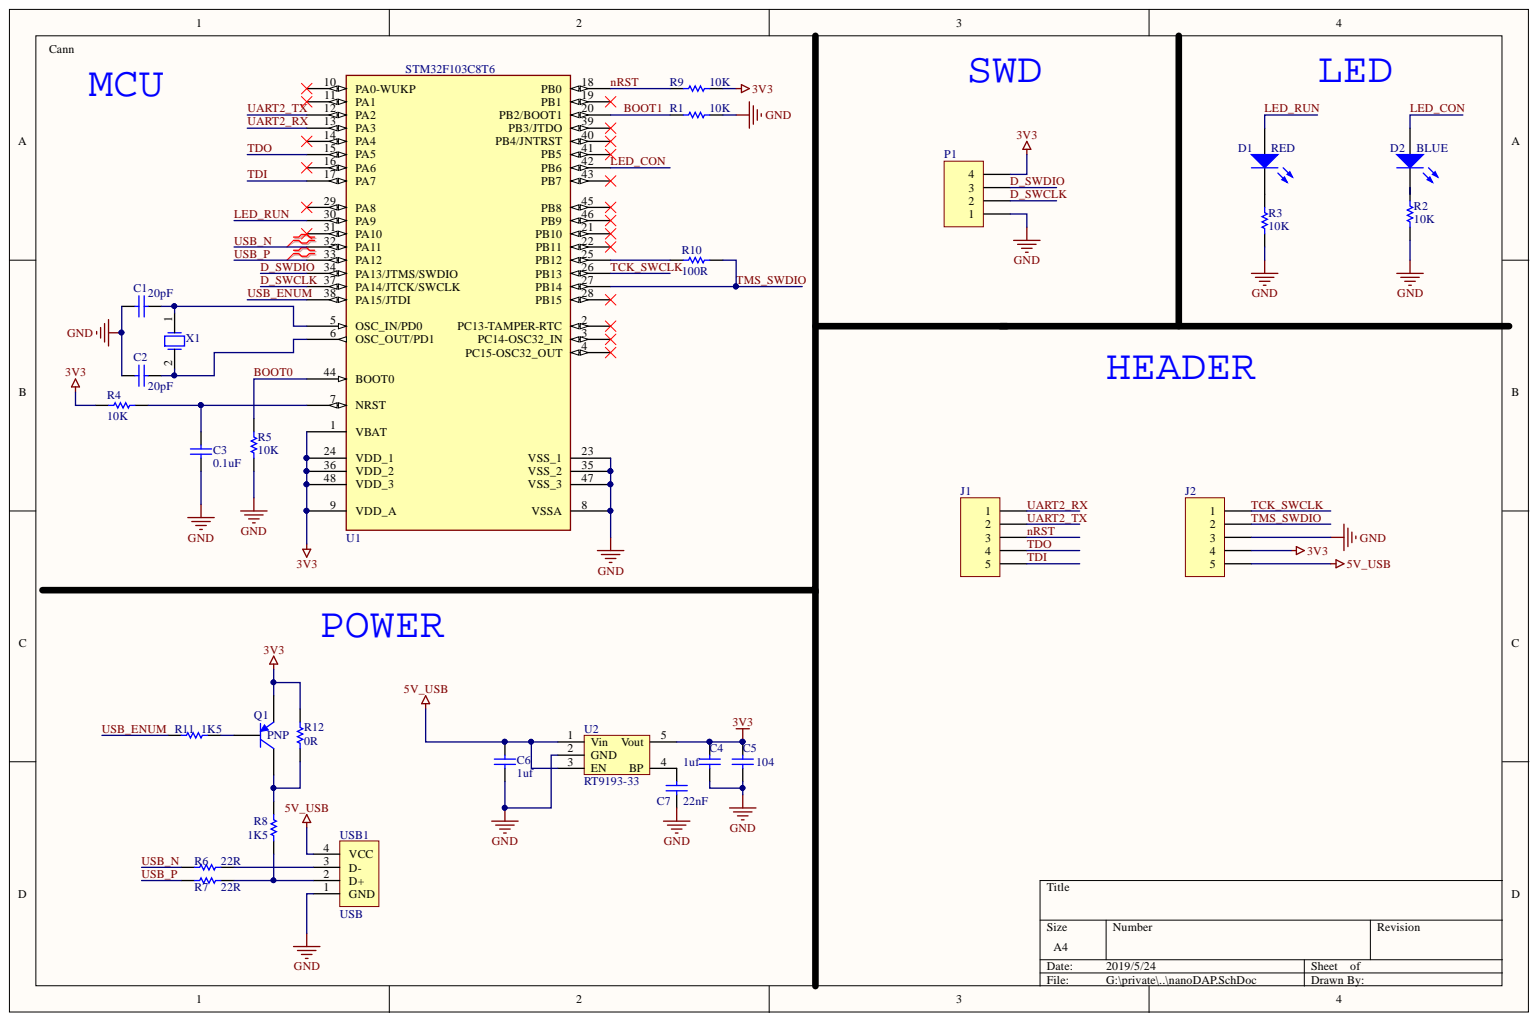
[picture p37: page 1]

3 6 | 3 5
4 8 | 4 7
