wuxx/nanoDAP/hardware/V2.0/nanoDAP.pdf

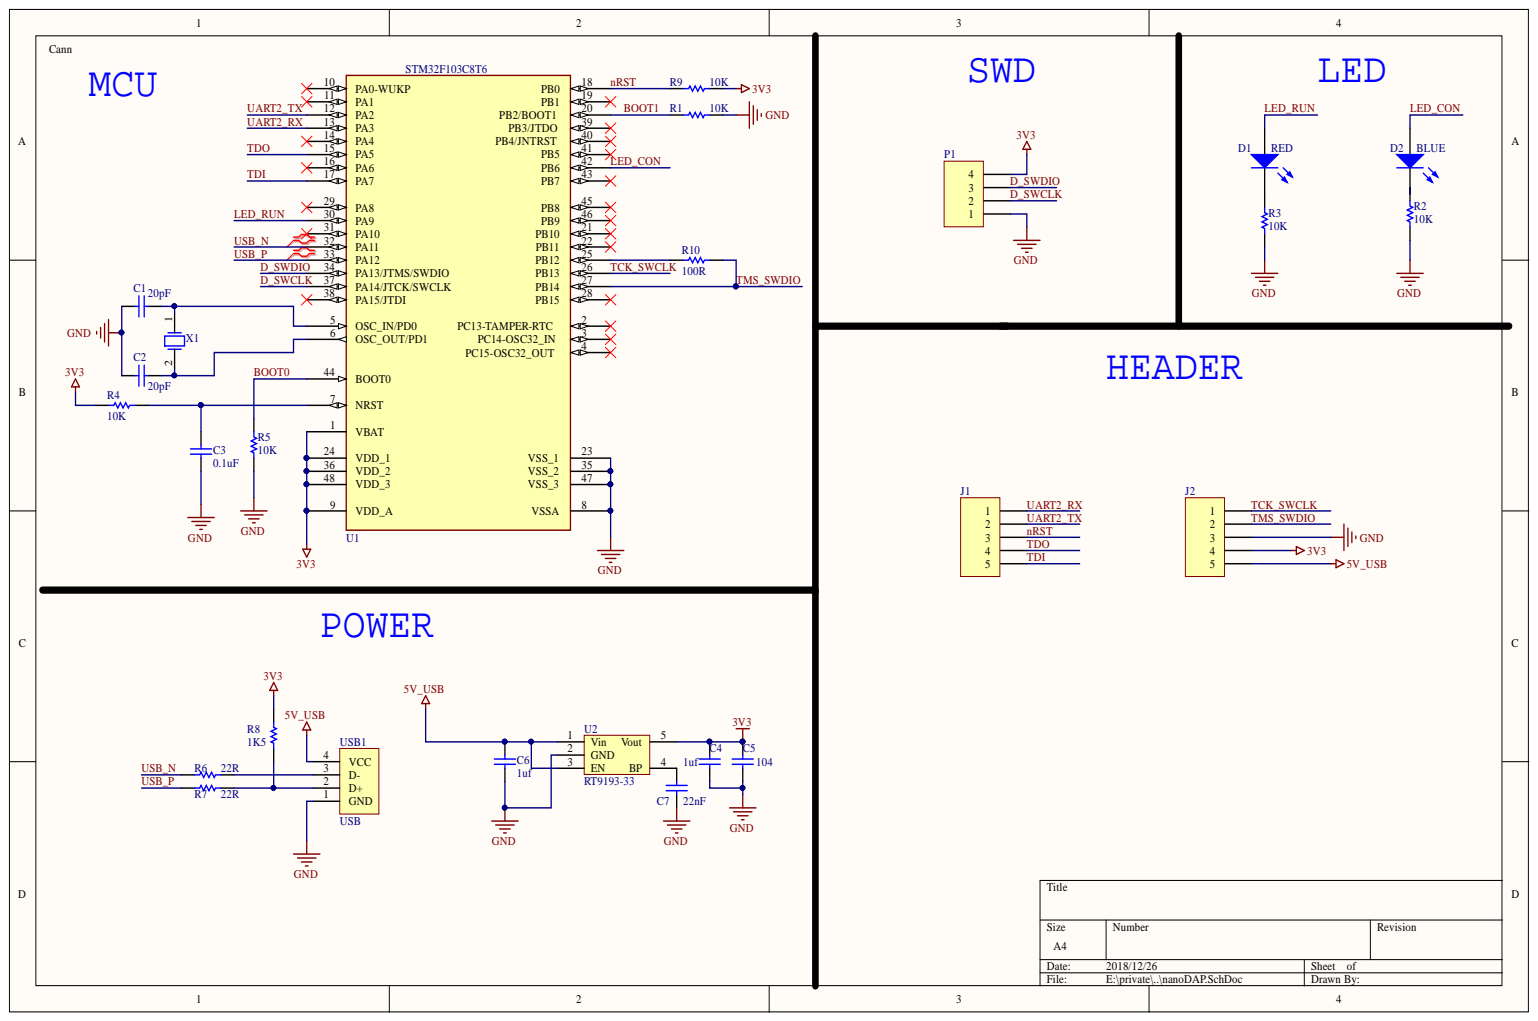
[picture p38: page 1]

3 6 | 3 5
4 8 | 4 7
