wuxx/nanoDAP/hardware/V1.0/nanoDAP-SCH.pdf

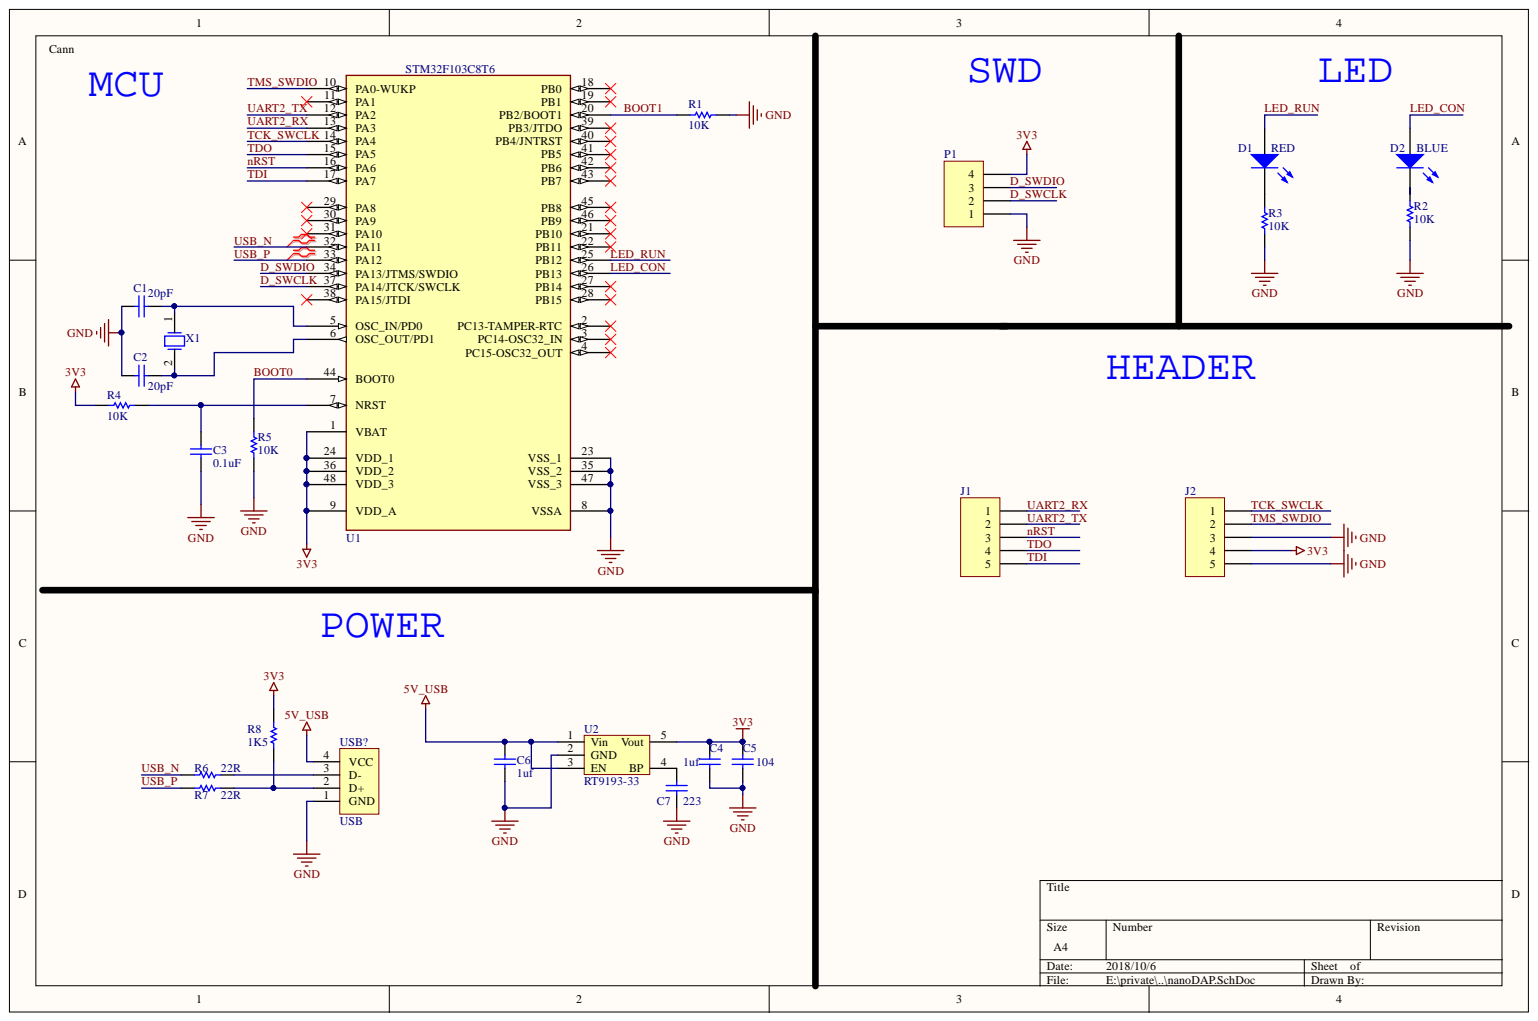
[picture p39: page 1]

3 6 | 3 5
4 8 | 4 7
