wuxx/nanoDAP/(list of files, drawings)

Other design files:
hardware/V1.0/nanoDAP.PcbDoc
hardware/V1.0/nanoDAP.PcbLib
hardware/V1.0/nanoDAP.PrjPcb
hardware/V1.0/nanoDAP.SchDoc
hardware/V1.0/nanoDAP.SCHLIB
