wuxx/nanoDAP/(commit log)

2018-09-27 add submodule STM32F103C8T6_CMSIS-DAP_SWO
2018-10-06 hardware source file commit.
    [nanoDAP.PcbDoc, nanoDAP.PcbLib, nanoDAP.PrjPcb, nanoDAP.SCHLIB, nanoDAP.SchDoc]
2019-05-24 add nanoDAP V2.1 hardware schematic
2019-05-29 add OpenOCD
    [100ask-openjtag.cfg, 8devices-lima.cfg, actux3.cfg, adapteva_parallella1.cfg, adsp-sc584-ezbrd.cfg, alphascale_asm9260_ek.cfg, altera-10m50.cfg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]
2019-08-10 下一个版本计划支持 stlink, jlink-ob, cmsis-dap, DAPLink, USB-Blaster以及更多有意思的固件，打造史上最强仿真器
2019-11-30 commit ARMMbed DAPLink source code with commit-id 30d84e1c0d6f8151d6eeb378e7ae6aafe3ce6e26
    [nxp_rapid_iot.yaml, rapid_iot.yaml]
2019-12-19 commit v2.3 schematic
2020-04-09 add support for even/odd check on hic_hal stm32
2020-05-29 update led_test
2020-05-29 add v2.3b and v2.3c
    [rapid_iot.yaml]
2020-05-29 commit v2.3b (support drag-and-drop (v2.3 has some bug which don't support drag-and-drop))
    [rapid_iot.yaml]
2020-05-29 commit v2.3c
    [rapid_iot.yaml]
2021-01-09 clean v2.3b
    [rapid_iot.yaml]
2024-04-09 commit DAPLink latest code, based on commit 0d6ed2fa1263d6f45cac1efa74e35c69dc51d24a
    [nxp_rapid_iot.yaml, rapid_iot.yaml]
